godzivan/OpenPSX2AmigaPadAdapter/OpenPSX2AmigaPadAdapter.kicad_pcb

## KiCad design OpenPSX2AmigaPadAdapter.kicad_pcb (2020-04-24)

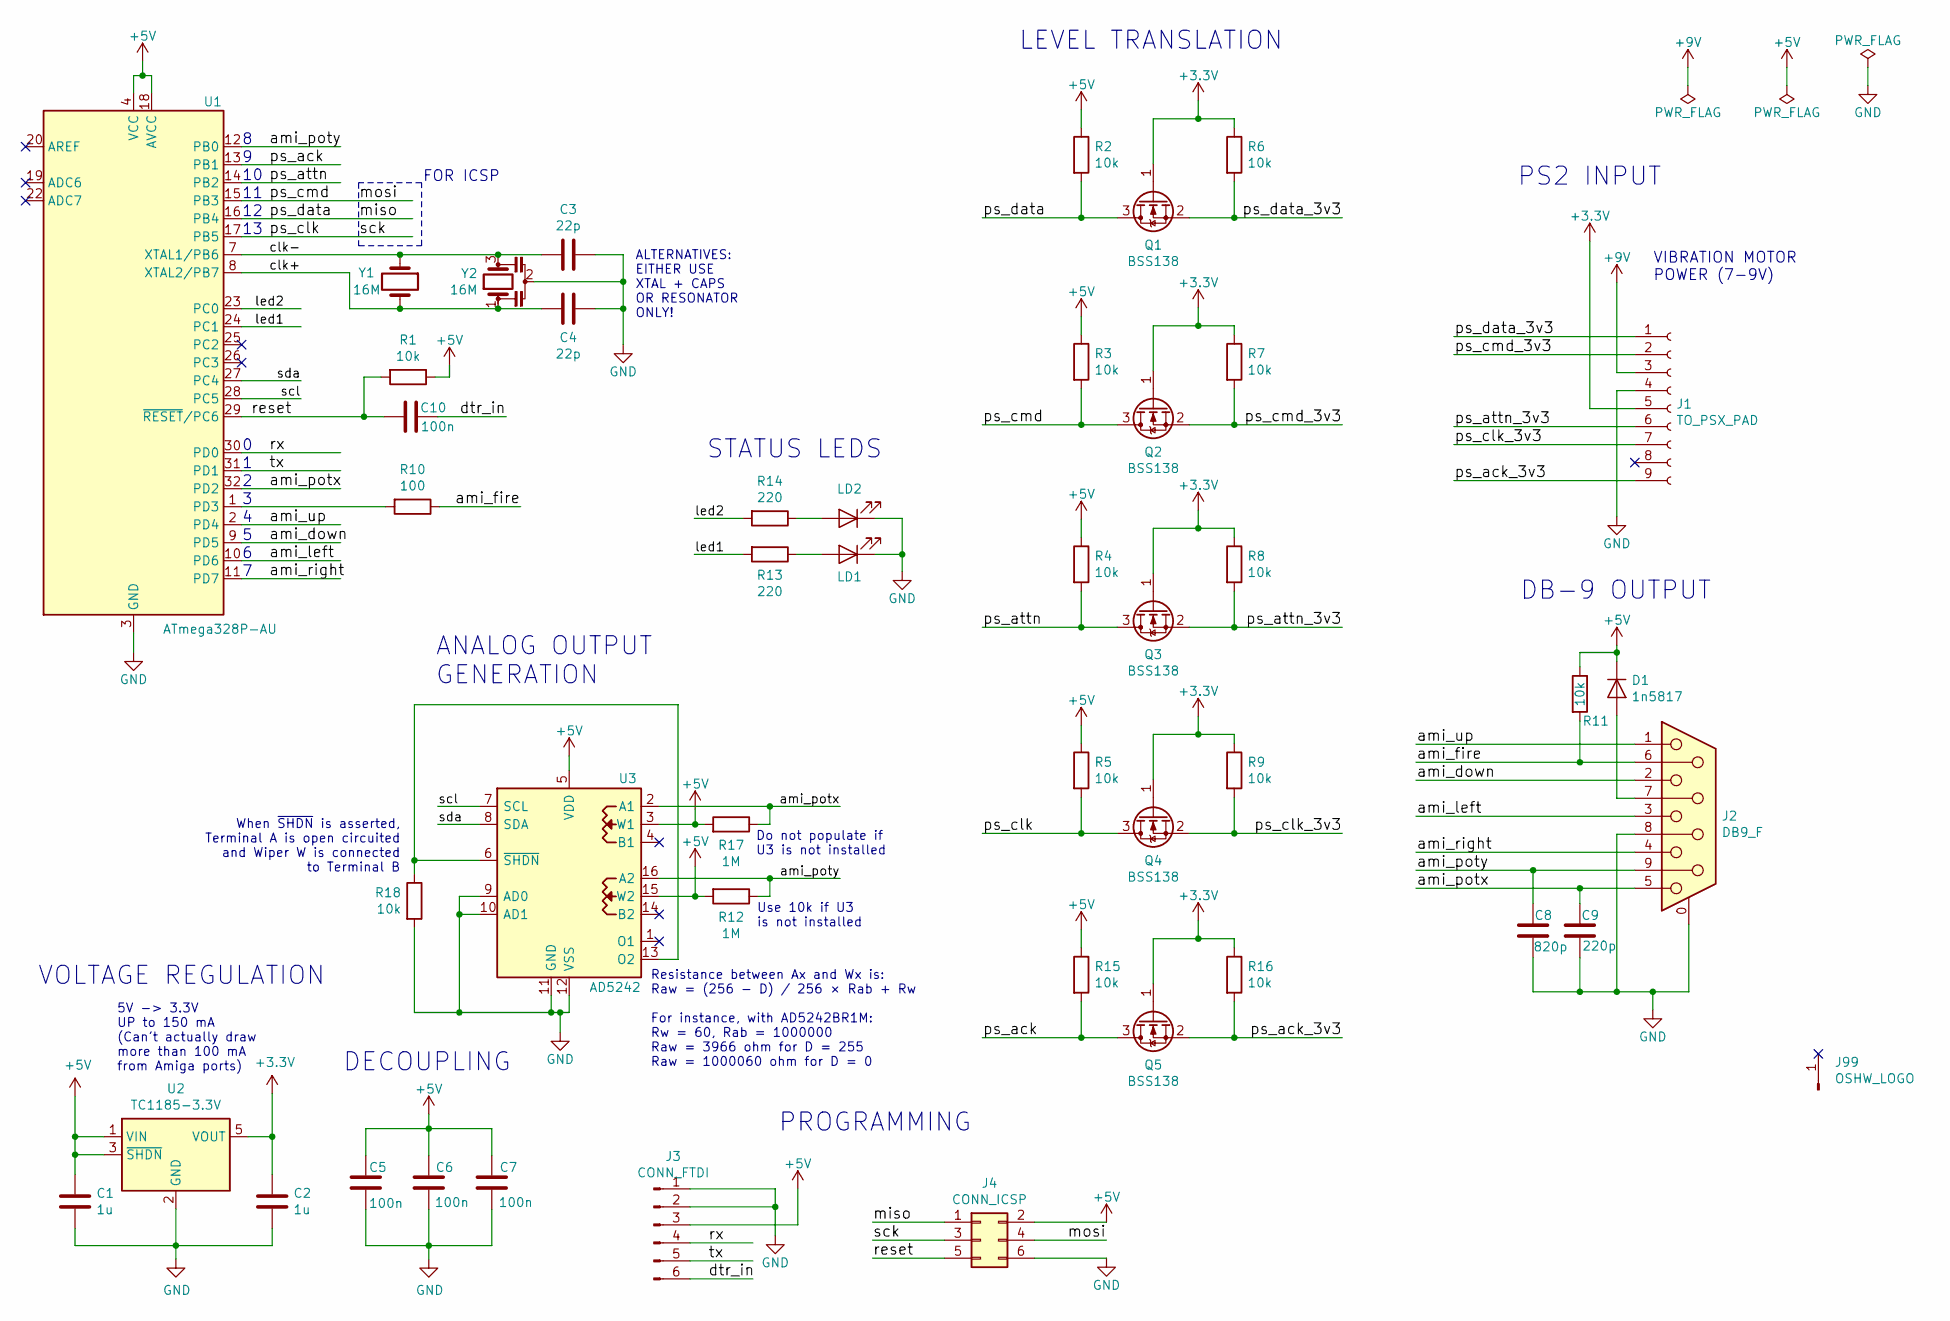
[picture p1: schematic OpenPSX2AmigaPadAdapter.sch]

Parts:
C1, C2: 1u; C_0805_2012Metric_Pad1.15x1.40mm_HandSolder
C3, C4: 22p; C_0805_2012Metric_Pad1.15x1.40mm_HandSolder
C5, C6, C7, C10: 100n; C_0805_2012Metric_Pad1.15x1.40mm_HandSolder
C8: 820p; C_0805_2012Metric_Pad1.15x1.40mm_HandSolder
C9: 220p; C_0805_2012Metric_Pad1.15x1.40mm_HandSolder
D1: 1n5817; D_SMA
J1: TO_PSX_PAD; PSX_Pad_Connector
J2: DB9_F; DB_9F
J3: CONN_FTDI; PinHeader_1x06_P2.54mm_Vertical
J4: CONN_ICSP; PinHeader_2x03_P2.54mm_Vertical
J99: OSHW_LOGO; OSHW-Logo_5.7x6mm_Copper
LD1, LD2: LED; LED_0805_2012Metric_Pad1.15x1.40mm_HandSolder
Q1, Q2, Q3, Q4, Q5: BSS138; SOT-23_Handsoldering
R1, R2, R3, R4, R5, R6, R7, R8, R9, R11, R15, R16, R18: 10k; R_0805_2012Metric_Pad1.15x1.40mm_HandSolder
R10: 100; R_0805_2012Metric_Pad1.15x1.40mm_HandSolder
R12, R17: 1M; R_0805_2012Metric_Pad1.15x1.40mm_HandSolder
R13, R14: 220; R_0805_2012Metric_Pad1.15x1.40mm_HandSolder
U1: ATmega328P-AU; TQFP-32_7x7mm_P0.8mm
U2: TC1185-3.3V; SOT-23-5_HandSoldering
U3: AD5242; SOIC-16_3.9x9.9mm_P1.27mm
Y1: 16M; Crystal_HC49-U_Vertical
Y2: 16M; Resonator_SMD_muRata_CSTxExxV

Connections:
+3V3: C2.1, J1.5, Q1.1 (G), Q2.1 (G), Q3.1 (G), Q4.1 (G), Q5.1 (G), R6.1, R7.1, R8.1, R9.1, R16.1, U2.5 (VOUT)
+5V: C1.1, C5.2, C6.2, C7.2, D1.1 (K), J3.3, J4.2, R1.1, R2.1, R3.1, R4.1, R5.1, R11.1, R12.2, R15.1, R17.2, U1.4 (VCC), U1.6 (VCC), U1.18 (AVCC), U2.1 (VIN), U2.3 (~SHDN), U3.3 (W1), U3.5 (VDD), U3.15 (W2)
/ami_down: J2.2, U1.9 (PD5)
/ami_fire: J2.6, R10.1, R11.2
/ami_left: J2.3, U1.10 (PD6)
/ami_potx: C9.1, J2.5, R17.1, U1.32 (PD2), U3.2 (A1)
/ami_poty: C8.1, J2.9, R12.1, U1.12 (PB0), U3.16 (A2)
/ami_right: J2.4, U1.11 (PD7)
/ami_up: J2.1, U1.2 (PD4)
/clk+: C4.2, U1.8 (XTAL2/PB7), Y1.2, Y2.1
/clk-: C3.2, U1.7 (XTAL1/PB6), Y1.1, Y2.3
/dtr_in: C10.1, J3.6
/led1: R13.2, U1.24 (PC1)
/led2: R14.2, U1.23 (PC0)
/miso: J4.1, Q1.3 (D), R2.2, U1.16 (PB4)
/mosi: J4.4, Q2.3 (D), R3.2, U1.15 (PB3)
/ps_ack: Q5.3 (D), R15.2, U1.13 (PB1)
/ps_ack_3v3: J1.9, Q5.2 (S), R16.2
/ps_attn: Q3.3 (D), R4.2, U1.14 (PB2)
/ps_attn_3v3: J1.6, Q3.2 (S), R8.2
/ps_clk: J4.3, Q4.3 (D), R5.2, U1.17 (PB5)
/ps_clk_3v3: J1.7, Q4.2 (S), R9.2
/ps_cmd_3v3: J1.2, Q2.2 (S), R7.2
/ps_data_3v3: J1.1, Q1.2 (S), R6.2
/reset: C10.2, J4.5, R1.2, U1.29 (~RESET~/PC6)
/rx: J3.4, U1.30 (PD0)
/scl: U1.28 (PC5), U3.7 (SCL)
/sda: U1.27 (PC4), U3.8 (SDA)
/tx: J3.5, U1.31 (PD1)
GND: C1.2, C2.2, C3.1, C4.1, C5.1, C6.1, C7.1, C8.2, C9.2, J1.4, J2.0 (PAD), J2.8, J3.1, J3.2, J4.6, LD1.1 (K), LD2.1 (K), R18.2, U1.3 (GND), U1.5 (GND), U1.21 (GND), U2.2 (GND), U3.9 (AD0), U3.10 (AD1), U3.11 (GND), U3.12 (VSS), Y2.2
unnamed: D1.2 (A), J2.7
unnamed: LD1.2 (A), R13.1
unnamed: LD2.2 (A), R14.1
unnamed: R10.2, U1.1 (PD3)
unnamed: R18.1, U3.6 (~SHDN~), U3.13 (O2)

Notes on the sheet:
VIBRATION MOTOR POWER (7-9V)
FOR ICSP
ALTERNATIVES: EITHER USE XTAL + CAPS OR RESONATOR ONLY!
When ~SHDN~ is asserted, Terminal A is open circuited and Wiper W is connected to Terminal B
5V -> 3.3V UP to 150 mA (Can't actually draw more than 100 mA from Amiga ports)
VOLTAGE REGULATION
DECOUPLING
ANALOG OUTPUT GENERATION
PROGRAMMING
STATUS LEDS
PS2 INPUT
DB-9 OUTPUT
LEVEL TRANSLATION
Resistance between Ax and Wx is: Raw = (256 − D) / 256 × Rab + Rw For instance, with AD5242BR1M: Rw = 60, Rab = 1000000 Raw = 3966 ohm for D = 255 Raw = 1000060 ohm for D = 0
Use 10k if U3 is not installed
Do not populate if U3 is not installed

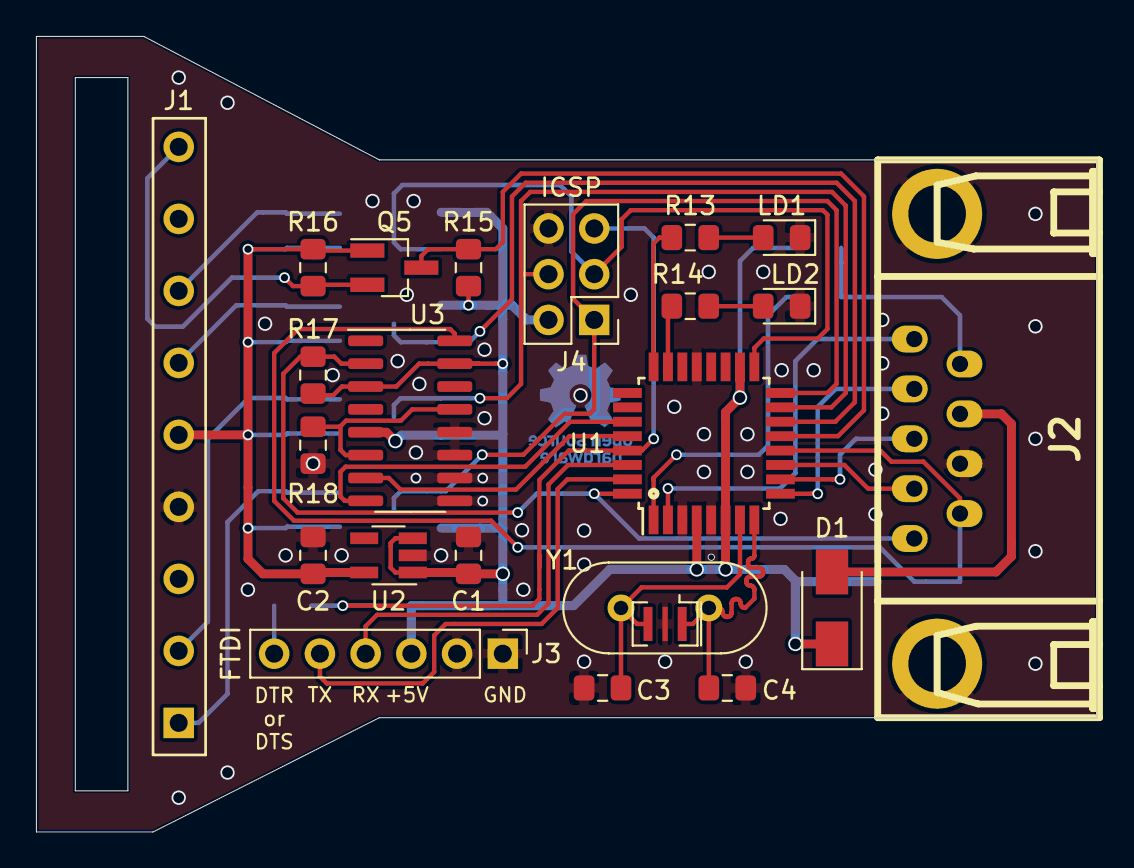
[picture p2: board OpenPSX2AmigaPadAdapter.kicad_pcb from above]

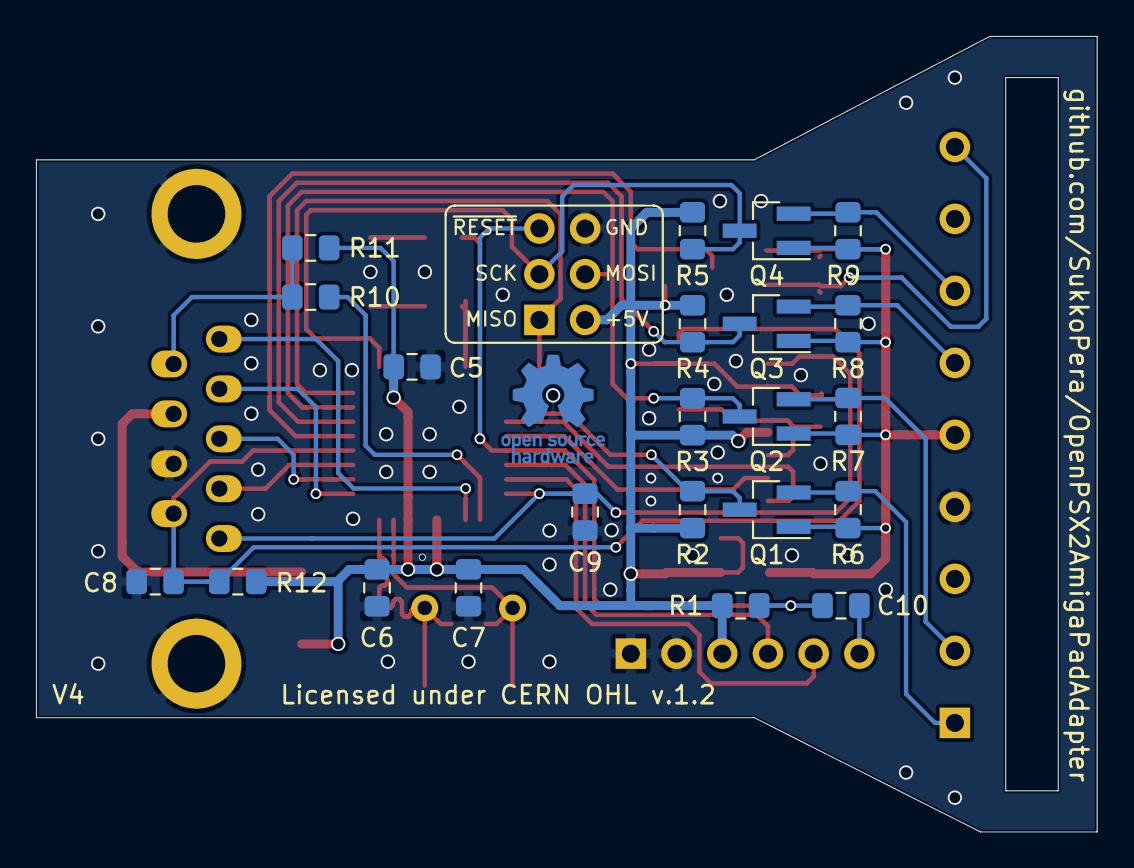
[picture p3: board OpenPSX2AmigaPadAdapter.kicad_pcb from below]

Board: 2 copper layers, 58.9 x 44.2 mm, 46 parts (23 on the bottom side), 35 nets.
