godzivan/OpenPSX2AmigaPadAdapter/firmware/OpenPSX2AmigaPadAdapter/OpenPSX2AmigaPadAdapter.ino

/*******************************************************************************
 * This file is part of OpenPSX2AmigaPadAdapter.                               *
 *                                                                             *
 * Copyright (C) 2019-2020 by SukkoPera <software@sukkology.net>               *
 *                                                                             *
 * OpenPSX2AmigaPadAdapter is free software: you can redistribute it and/or    *
 * modify it under the terms of the GNU General Public License as published by *
 * the Free Software Foundation, either version 3 of the License, or           *
 * (at your option) any later version.                                         *
 *                                                                             *
 * OpenPSX2AmigaPadAdapter is distributed in the hope that it will be useful,  *
 * but WITHOUT ANY WARRANTY; without even the implied warranty of              *
 * MERCHANTABILITY or FITNESS FOR A PARTICULAR PURPOSE.  See the               *
 * GNU General Public License for more details.                                *
 *                                                                             *
 * You should have received a copy of the GNU General Public License           *
 * along with OpenPSX2AmigaPadAdapter. If not, see http://www.gnu.org/licenses.*
 ******************************************************************************/
/**
 * \file OpenPSX2AmigaPadAdapter.ino
 * \author SukkoPera <software@sukkology.net>
 * \date 26 Mar 2020
 * \brief Playstation to Commodore Amiga/CD32 controller adapter
 *
 * Please refer to the GitHub page and wiki for any information:
 * https://github.com/SukkoPera/OpenPSX2AmigaPadAdapter
 */

#include <PsxNewLib.h>
#include <PsxControllerHwSpi.h>

/** \brief Enable heavy optimization
 * 
 * This enables some inline assembly code, GCC-style ISRs, etc.
 * 
 * Code has only been tested with this being enabled, so you'd better not touch
 * it.
 */
#define SUPER_OPTIMIZE

/** \brief Enable fast control of I/O pins
 *
 * This enables very fast (2 clock cycles) control of I/O pins. The DigitalIO
 * library by greiman is needed for this: https://github.com/greiman/DigitalIO.
 * 
 * This is basically mandatory for all targets currently supported, where the
 * Arduino digitalRead()/digitalWrite() functions are too slow. This define is
 * provided to make it easy to transition to faster platforms one day, should we
 * ever want to.
 */
#define ENABLE_FAST_IO

/** \def ENABLE_INSTRUMENTATION
 * 
 * \brief Enable code instrumentation
 *
 * This makes a couple of I/O pins toggle whenever ISRs are entered and is a
 * means to measure how long they take to execute fully, by using a logic
 * analyzer or oscilloscope.
 * 
 * Disabled by default.
 */
//~ #define ENABLE_INSTRUMENTATION

/** \def DISABLE_FACTORY_RESET
 *
 * \brief Disable factory reset
 * 
 * This disables the factory reset for joystick configurations. The only point
 * here is to save some flash, for ATmega88 targets. EEPROM can be cleared with
 * the \a eeprom_clear Arduino example.
 * 
 * At the moment we fit on all supported targets with this enabled, so just
 * ignore it.
 */
//~ #define DISABLE_FACTORY_RESET

/** \def #ifndef DISABLE_TEST_MODE
 *
 * \brief Disable controller test mode
 * 
 * This disables the controller test mode that is entered by holding \a START
 * at power-up. The only point again is to save some flash, for ATmega88
 * targets.
 */
//~ #define DISABLE_TEST_MODE

/** \def DISABLE_EEPROM
 *
 * \brief Disable EEPROM support
 * 
 * This disables loading and storing controller configurations from/to the
 * internal EEPROM. Only useful for development.
 */
//~ #define DISABLE_EEPROM

/** \def ENABLE_ANALOG_SUPPORT
 *
 * \brief Enable support for analog joystick output
 *
 * This enables capability for the adapter to appear as an analog joystick. The
 * horizontal and vertical movement of the controller will be somehow reflected
 * on the PotX and PotY pins. Of course this will only work if an analog-capable
 * controller is connected.
 *
 * A V4 PCB with an AD5242 chip is needed for this functionality.
 */
#define ENABLE_ANALOG_SUPPORT

//~ #define DISABLE_ANALOG_OUTPUT_COMPENSATION

//! \name OUTPUT pins, connected to Amiga port
//! @{
const byte PIN_UP = 4;    //!< Amiga Pin 1
const byte PIN_DOWN = 5;  //!< Amiga Pin 2
const byte PIN_LEFT = 6;  //!< Amiga Pin 3
const byte PIN_RIGHT = 7; //!< Amiga Pin 4
const byte PIN_BTN1 = 3;  //!< Amiga Pin 6
const byte PIN_BTN2 = 8;  //!< Amiga Pin 9
//! @}

/** \brief Controller mode input pin
 *  
 * This pin switches between Amiga (HIGH) and CD32 (LOW) mode.
 * 
 * It also triggers the loading of the button status shift register.
 */
const byte PIN_PADMODE = 2; // Amiga Pin 5

/** \brief Shift register output pin for CD32 mode
 * 
 * When in CD32 mode, button status is saved to an 8-bit register that gets
 * shifted out one bit at a time through this pin.
 */
const byte PIN_BTNREGOUT = PIN_BTN2;

/** \brief Shift register clock input pin for CD32 mode
 * 
 * The shifting is clocked by rising edges on this pin.
 */
const byte PIN_BTNREGCLK = PIN_BTN1;

#ifdef ENABLE_ANALOG_SUPPORT
/** \brief PotX Analog input pin
 * 
 * Only used in analog mode. Note that most games actually use this for the Y
 * axis.
 *
 * \sa PIN_POTY
 */
const byte PIN_POTX = PIN_PADMODE;		// Pin 5

/** \brief PotY Analog input pin
 * 
 * Only used in analog mode.
 *
 * \sa PIN_POTX
 */
const byte PIN_POTY = PIN_BTN2;			// Pin 5

const byte RDAC_PULLUP_VALUE = 253;		// 11642 ohm
#endif

/** \brief Dead zone for analog sticks
 *  
 * If the analog stick moves less than this value from the center position, it
 * is considered still.
 * 
 * \sa ANALOG_IDLE_VALUE
 */
const byte ANALOG_DEAD_ZONE = 50U;

/** \brief Controller polling frequency
 *
 * Polling the PS2 controller takes a considerable amount of time, so we cannot
 * do that all the time. Considering that an Amiga game cannot read inputs more
 * than once every frame, 60 seems a reasonable value here, taking care of both
 * PAL and NTSC machines.
 */
const byte PAD_POLLING_FREQ = 60U;

/** \brief Delay of the quadrature square waves when mouse is moving at the
 * \a slowest speed
 */
const byte MOUSE_SLOW_DELTA	= 250U;

/** \brief Delay of the quadrature square waves when mouse is moving at the
 * \a fastest speed.
 */
const byte MOUSE_FAST_DELTA = 10U;

/** \brief LED2 pin
 * 
 * Pin for led that lights up whenever the proper controller is detected.
 */
const byte PIN_LED_PAD_OK = A1;

/** \brief LED1 pin
 * 
 * Pin for led that lights up whenever the adapter is in CD32 mode.
 */
const byte PIN_LED_MODE = A0;

/** \brief Pin used for Controller Attention (ATTN)
 *
 * Pin that makes the controller pay attention to what we're saying.
 */
const byte PIN_CONTROLLER_ATTN = 10;

/** \brief CD32 mode timeout
 * 
 * Normal joystick mode will be entered if PIN_PADMODE is not toggled for this
 * amount of milliseconds.
 * 
 * Keep in mind that in normal conditions it is toggled once per frame (i.e.
 * every ~20 ms).
 */
const byte TIMEOUT_CD32_MODE = 100U;

/** \brief Programming mode timeout
 * 
 * Programming mode will be entered if SELECT + a button are held for this
 * amount of milliseconds.
 */
const unsigned long TIMEOUT_PROGRAMMING_MODE = 1000U;

/** \brief Single-button debounce time
 * 
 * A combo will be considered valid only after it has been stable for this
 * amount of milliseconds.
 * 
 * \sa debounceButtons()
 */
const unsigned long DEBOUNCE_TIME_BUTTON = 30U;

/** \brief Combo debounce time
 * 
 * A combo will be considered valid only after it has been stable for this
 * amount of milliseconds. This needs to be greater than #DEBOUNCE_TIME_BUTTON
 * to allow combos to be entered correctly, as it's hard to press several
 * buttons at exactly the same moment.
 * 
 * \sa debounceButtons()
 */
const unsigned long DEBOUNCE_TIME_COMBO = 150U;


/*******************************************************************************
 * DEBUGGING SUPPORT
 ******************************************************************************/

// Send debug messages to serial port
//~ #define ENABLE_SERIAL_DEBUG

// Print the controller status on serial. Useful for debugging.
//~ #define DEBUG_PAD

// Print the duration of every loop() iteration
//~ #define ENABLE_DEBUG_LOOP_DURATION


/*******************************************************************************
 * END OF SETTINGS
 ******************************************************************************/

#ifndef DISABLE_EEPROM
#include <EEPROM.h>
#include <util/crc16.h>
#endif

#ifdef ENABLE_FAST_IO
#include <DigitalIO.h>		// https://github.com/greiman/DigitalIO
#else
#define fastDigitalRead(x) digitalRead(x)
#define fastDigitalWrite(x, y) digitalWrite(x, y)
#define fastPinMode(x, y) pinMode(x, y)
#endif

#ifdef ENABLE_INSTRUMENTATION
#define PIN_INTERRUPT_TIMING A2
#define PIN_CD32MODE A4
#endif

#ifdef ENABLE_ANALOG_SUPPORT
#include "VariableResistor.h"
VariableResistor variableResistor;
boolean haveAnalogCapability = false;
#endif

//! \name Button bits for CD32 mode
//! @{
const byte BTN_BLUE =		1U << 0U;	//!< \a Blue Button
const byte BTN_RED =		1U << 1U;	//!< \a Red Button
const byte BTN_YELLOW =		1U << 2U;	//!< \a Yellow Button
const byte BTN_GREEN =		1U << 3U;	//!< \a Green Button
const byte BTN_FRONT_R =	1U << 4U;	//!< \a Front \a Right Button
const byte BTN_FRONT_L =	1U << 5U;	//!< \a Front \a Left Button
const byte BTN_START =		1U << 6U;	//!< \a Start/Pause Button
//! @}

#define ATTR_PACKED __attribute__((packed))

/** \brief State machine states
 * 
 * Possible states for the internal state machine that drives the whole thing.
 * 
 * Note that we make this \a packed so that it fits in a single byte.
 */
enum ATTR_PACKED State {
	ST_NO_CONTROLLER,			//!< No controller connected
	ST_FIRST_READ,				//!< First time the controller is read

#ifndef DISABLE_TEST_MODE
	ST_TEST_MODE,				//!< Controller test mode
#endif
	
	// Main functioning modes
	ST_JOYSTICK,				//!< Two-button joystick mode
	ST_MOUSE,					//!< Mouse mode
	ST_CD32,					//!< CD32-controller mode
	ST_JOYSTICK_TEMP,			//!< Just come out of CD32 mode, will it last?
	
	// States to select mapping or go into programming mode
	ST_SELECT_HELD,				//!< Select being held
	ST_SELECT_AND_BTN_HELD,		//!< Select + mapping button being held
	ST_ENABLE_MAPPING,			//!< Select + mapping button released, enable mapping
	
	// States for programming mode
	ST_WAIT_SELECT_RELEASE,		//!< Select released, entering programming mode
	ST_WAIT_BUTTON_PRESS,		//!< Programmable button pressed
	ST_WAIT_BUTTON_RELEASE,		//!< Programmable button released
	ST_WAIT_COMBO_PRESS,		//!< Combo pressed
	ST_WAIT_COMBO_RELEASE,		//!< Combo released
	ST_WAIT_SELECT_RELEASE_FOR_EXIT,	//!< Wait for select to be released to go back to joystick mode
	
	// States for factory reset
#ifndef DISABLE_FACTORY_RESET
	ST_FACTORY_RESET_WAIT_1,
	ST_FACTORY_RESET_WAIT_2,
	ST_FACTORY_RESET_PERFORM,
#endif

	// States for analog output support
#ifdef ENABLE_ANALOG_SUPPORT
	ST_ANALOG,					//!< Analog joystick mode
	ST_ANALOG_SELECT_HELD,
	ST_ANALOG_SELECT_AND_BTN_HELD,
	ST_ANALOG_ENABLE_MAPPING,
#endif
};

/** \brief All possible button mappings
 * 
 * This is only used for blinking the led when mapping is changed
 */
enum ATTR_PACKED JoyButtonMapping {
	JMAP_NORMAL = 1,
	JMAP_RACING1,
	JMAP_RACING2,
	JMAP_PLATFORM,
	JMAP_CUSTOM
};

/** \brief Structure representing a standard 2-button Atari-style joystick
 * 
 * This is used for gathering button presses according to different button
 * mappings.
 * 
 * True means pressed.
 * 
 * We use bitfields so that it all fits in a single byte.
 */
struct TwoButtonJoystick {
	boolean up: 1;			//!< Up/Forward direction
	boolean down: 1;		//!< Down/Backwards direction
	boolean left: 1;		//!< Left direction
	boolean right: 1;		//!< Right direction
	boolean b1: 1;			//!< Button 1
	boolean b2: 1;			//!< Button 2
};

#ifdef ENABLE_ANALOG_SUPPORT
/** \brief Structure representing an Analog Joystick for the Amiga
 * 
 * This is used for gathering axis movement and button presses.
 * 
 * For the buttons, \a True means pressed. Note that most (if not all) games
 * support up to 2 buttons, but the \a AnaCal calibration program supports 4, so
 * why not?
 */
struct AnalogJoystick {
	byte analogX;			//!< Horizontal axis
	byte analogY;			//!< Vertical axis
	boolean b1: 1;			//!< Button 1
	boolean b2: 1;			//!< Button 2
	boolean b3: 1;			//!< Button 3
	boolean b4: 1;			//!< Button 4
};
#endif

/** \brief Map a PSX button to a two-button-joystick combo
 * 
 * There's an entry for every button, even those that cannot be mapped, for
 * future extension.
 *
 * Use #psxButtonToIndex() to convert a button to the index to use in the array.
 * 
 * \sa isButtonMappable()
 */
struct ControllerConfiguration {
	/** Two-button joystick combo to send out when the corresponding button is
	 * pressed
	 */
	TwoButtonJoystick buttonMappings[PSX_BUTTONS_NO];
};

//! \name Global variables
//! @{

//! PS2 Controller Class
PsxControllerHwSpi<PIN_CONTROLLER_ATTN> psx;

/** \brief Current state of the internal state machine
 * 
 * We start out as a simple joystick.
 * 
 * We keep this in \a GPIOR2 for faster access and slimmer code.
 * 
 * \hideinitializer
 */
volatile State *state = reinterpret_cast<volatile State *> (&GPIOR2);

/** \brief All possible controller configurations
 * 
 * Since these are activated with SELECT + a button, ideally there can be as
 * many different ones as other buttons we have (i.e.: PSX_BUTTONS_NO). In
 * practice, we will start handling only a handful.
 */
ControllerConfiguration controllerConfigs[PSX_BUTTONS_NO];

//! \brief Custom controller configuration currently selected
ControllerConfiguration *currentCustomConfig = NULL;

/** \brief Button register for CD32 mode being updated
 * 
 * This shall be updated as often as possible, and is what gets sampled when we
 * get a falling edge on #PIN_PADMODE.
 * 
 * 0 means pressed, MSB must be 1 for the ID sequence.
 * 
 * We keep this in \a GPIOR0 for faster ISR code. Note that GPIOR0 is one of the
 * lowest 64 registers on ATmega88/168/328's, thus it can be used with
 * SBI/CBI/SBIC/SBIS. I don't know if GCC takes advantage of this, but we do in
 * the \a asm_isr branch.
 * 
 * \hideinitializer
 */
volatile byte *buttonsLive = &GPIOR0;

/** \brief Button register for CD32 mode currently being shifted out
 * 
 * This is where #buttonsLive gets copied when it is sampled.
 * 
 * 0 means pressed, etc.
 * 
 * We keep this in \a GPIOR1 for faster ISR code.
 * 
 * \hideinitializer
 */
volatile byte *isrButtons = &GPIOR1;

/** \brief Joystick mapping function
 * 
 * This represents a function that should inspect the buttons currently being
 * pressed on the PSX controller and somehow map them to a #TwoButtonJoystick to
 * be sent to the DB-9 port.
 */
typedef void (*JoyMappingFunc) (TwoButtonJoystick& j);

// Default button mapping function prototype for initialization of the following
void mapJoystickNormal (TwoButtonJoystick& j);

//! \brief Joystick mapping function currently in effect (Digital Mode)
JoyMappingFunc joyMappingFunc = mapJoystickNormal;

#ifdef ENABLE_ANALOG_SUPPORT
/** \brief Analog Joystick mapping function
 * 
 * This represents a function that should inspect the buttons currently being
 * pressed on the PSX controller and somehow map them to a #AnalogJoystick to be
 * sent to the DB-9 port.
 */
typedef void (*AnalogJoyMappingFunc) (AnalogJoystick& j);

void mapJoystickAnalogLeft (AnalogJoystick& j);

//! \brief Joystick mapping function currently in effect (Analog Mode)
AnalogJoyMappingFunc analogJoyMappingFunc = mapJoystickAnalogLeft;

/** \brief Swap X/Y axes
 * 
 * There is no real standard for analog joysticks on the Amiga, so different
 * games map the X/Y axes differently. Let's cope with that!
 */
boolean swapAnalogAxes = false;

#ifndef DISABLE_ANALOG_OUTPUT_COMPENSATION

const byte rcompensated[256] = {
	255,  255,  255,  255,  254,  254,  253,  253,  
	252,  252,  251,  251,  250,  250,  249,  249,  
	248,  248,  247,  247,  246,  246,  245,  245,  
	244,  244,  243,  243,  242,  242,  241,  241,  
	240,  240,  239,  238,  238,  237,  237,  236,  
	236,  235,  235,  234,  234,  233,  232,  232,  
	231,  231,  230,  230,  229,  228,  228,  227,  
	227,  226,  226,  225,  224,  224,  223,  223,  
	222,  221,  221,  220,  219,  219,  218,  218,  
	217,  216,  216,  215,  215,  214,  213,  213,  
	212,  211,  211,  210,  209,  209,  208,  207,  
	207,  206,  205,  205,  204,  203,  203,  202,  
	201,  201,  200,  199,  198,  198,  197,  196,  
	196,  195,  194,  193,  193,  192,  191,  190,  
	190,  189,  188,  187,  187,  186,  185,  184,  
	184,  183,  182,  181,  181,  180,  179,  178,  
	177,  177,  176,  175,  174,  173,  172,  172,  
	171,  170,  169,  168,  167,  167,  166,  165,  
	164,  163,  162,  161,  161,  160,  159,  158,  
	157,  156,  155,  154,  153,  152,  151,  150,  
	150,  149,  148,  147,  146,  145,  144,  143,  
	142,  141,  140,  139,  138,  137,  136,  135,  
	134,  133,  132,  131,  130,  129,  128,  126,  
	125,  124,  123,  122,  121,  120,  119,  118,  
	117,  116,  114,  113,  112,  111,  110,  109,  
	107,  106,  105,  104,  103,  102,  100,  99,  
	98,  97,  95,  94,  93,  92,  90,  89,  
	88,  86,  85,  84,  83,  81,  80,  79,  
	77,  76,  74,  73,  72,  70,  69,  67,  
	66,  65,  63,  62,  60,  59,  57,  56,  
	54,  53,  51,  50,  48,  47,  45,  44,  
	42,  40,  39,  37,  36,  34,  32,  31,  
};

#endif

#endif

/** \brief Commodore 64 mode
 *
 * Button 2 on the C64 is usually expected to behave differently from the other
 * buttons, so that it is HIGH when pressed and LOW when released.
 *
 * If this flag is true, we'll do exactly that.
 */
boolean c64Mode = false;

/** \brief Use alternative CD32 mapping
 * 
 * To me the Red button maps naturally to Square, Blue to Cross and so on. Some
 * people feel this way buttons are "rotated" with regard to the original CD32
 * controller, hence let's give them the possibility to "counter-rotate" the
 * mapping so that Cross is Red, Circle is Blue and so on.
 */
boolean useAlternativeCd32Mapping = false;

/** \brief Inhibit CD32 mode
 * 
 * This inhibits the CD32 mode. Useful in those cases where pin 5 is not kept
 * high.
 *
 * This is enabled by holding \a Cross at power-up.
 */
boolean inhibitCd32Mode = false;

//! @}		// End of global variables

#ifdef ENABLE_SERIAL_DEBUG
	#include <avr/pgmspace.h>
	typedef const __FlashStringHelper * FlashStr;
	typedef const byte* PGM_BYTES_P;
	#define PSTR_TO_F(s) reinterpret_cast<const __FlashStringHelper *> (s)

	#define dstart(spd) Serial.begin (spd)
	#define debug(...) Serial.print (__VA_ARGS__)
	#define debugln(...) Serial.println (__VA_ARGS__)
#else
	#define dstart(...)
	#define debug(...)
	#define debugln(...)
#endif

/** \brief Initialize the Playstation controller
 * 
 * Note that this function takes a considerable amount of time.
 * 
 * \return True if a supported controller was found, false otherwise.
 */
boolean initPad () {
	boolean ret = false;

	// clock, command, attention, data, Pressures?, Rumble?
	if (psx.begin ()) {
		// Controller seems ready
		if (!psx.enterConfigMode ()) {
			/* We'll take this as good anyway, maybe it's an early controller
			 * that does not support any configuration, like the Namco Arcade
			 * Stick
			 */
			debugln (F("Cannot enter config mode"));
			ret = true;
		} else {
			switch (psx.getControllerType ()) {
			case PSCTRL_UNKNOWN:
				/* The Dual Shock controller gets recognized as this sometimes, or
				 * anyway, whatever controller it is, it might work
				 */
				debugln (F("Unknown Controller type found, using anyway"));
				ret = true;
				break;
			case PSCTRL_DUALSHOCK:
				debugln (F("DualShock Controller found"));
				ret = true;
				break;
			case PSCTRL_GUITHERO:
				/* We used to refuse this, as it does not look suitable, but then we
				 * found out that the Analog Controller (SCPH-1200) gets detected as
				 * this... :/
				 */
				debugln (F("Analog/GuitarHero Controller found"));
				ret = true;
				break;
			case PSCTRL_DSWIRELESS:
				debugln (F("Wireless Sony DualShock Controller found"));
				ret = true;
				break;
			}

			// Try to enable analog sticks
			if (!psx.enableAnalogSticks ()) {
				debugln (F("Cannot enable analog sticks"));
			}
							
			if (!psx.exitConfigMode ()) {
				debugln (F("Cannot exit config mode"));
			}
		}
	} else {
		debugln (F("No controller found"));
	}

	return ret;
}


/** \name Button name strings
 * 
 * These are only used for debugging and will not show up in the executable if
 * it is not enabled
 */
//! @{
const char buttonSelectName[] PROGMEM = "Select";
const char buttonL3Name[] PROGMEM = "L3";
const char buttonR3Name[] PROGMEM = "R3";
const char buttonStartName[] PROGMEM = "Start";
const char buttonUpName[] PROGMEM = "Up";
const char buttonRightName[] PROGMEM = "Right";
const char buttonDownName[] PROGMEM = "Down";
const char buttonLeftName[] PROGMEM = "Left";
const char buttonL2Name[] PROGMEM = "L2";
const char buttonR2Name[] PROGMEM = "R2";
const char buttonL1Name[] PROGMEM = "L1";
const char buttonR1Name[] PROGMEM = "R1";
const char buttonTriangleName[] PROGMEM = "Triangle";
const char buttonCircleName[] PROGMEM = "Circle";
const char buttonCrossName[] PROGMEM = "Cross";
const char buttonSquareName[] PROGMEM = "Square";

const char* const psxButtonNames[PSX_BUTTONS_NO] PROGMEM = {
	buttonSelectName,
	buttonL3Name,
	buttonR3Name,
	buttonStartName,
	buttonUpName,
	buttonRightName,
	buttonDownName,
	buttonLeftName,
	buttonL2Name,
	buttonR2Name,
	buttonL1Name,
	buttonR1Name,
	buttonTriangleName,
	buttonCircleName,
	buttonCrossName,
	buttonSquareName
};
//! @}

/** \brief Convert a button on the PSX controller to a small integer
 * 
 * Output will always be in the range [0, PSX_BUTTONS_NO - 1] and is not
 * guaranteed to be valid, so it should be checked to be < PSX_BUTTONS_NO before
 * use.
 * 
 * \param[in] psxButtons Button to be converted
 * \return A small integer corresponding to the "first" button pressed
 */
byte psxButtonToIndex (PsxButtons psxButtons) {
	byte i;

	for (i = 0; i < PSX_BUTTONS_NO; ++i) {
		if (psxButtons & 0x01) {
			break;
		}

		psxButtons >>= 1U;
	}

	return i;
}

#ifdef ENABLE_SERIAL_DEBUG
/** \brief Return the name of a PSX button
 * 
 * \param[in] psxButtons Button to be converted
 * \return A string (in flash) containing the name of the "first" buton pressed
 */
FlashStr getButtonName (const PsxButtons psxButton) {
	FlashStr ret = F("");
	
	byte b = psxButtonToIndex (psxButton);
	if (b < PSX_BUTTONS_NO) {
		PGM_BYTES_P bName = reinterpret_cast<PGM_BYTES_P> (pgm_read_ptr (&(psxButtonNames[b])));
		ret = PSTR_TO_F (bName);
	}

	return ret;
}
#endif

/** \brief Print the names of all PSX buttons being pressed
 * 
 * \param[in] psxButtons Buttons to be printed
 */
void dumpButtons (const PsxButtons psxButtons) {
#ifdef DEBUG_PAD
	static PsxButtons lastB = 0;

	if (psxButtons != lastB) {
		lastB = psxButtons;			// Save it before we alter it
		
		debug (F("Pressed: "));

		for (byte i = 0; i < PSX_BUTTONS_NO; ++i) {
			byte b = psxButtonToIndex (psxButtons);
			if (b < PSX_BUTTONS_NO) {
				PGM_BYTES_P bName = reinterpret_cast<PGM_BYTES_P> (pgm_read_ptr (&(psxButtonNames[b])));
				debug (PSTR_TO_F (bName));
			}

			psxButtons &= ~(1 << b);

			if (psxButtons != 0) {
				debug (F(", "));
			}
		}

		debugln ();
	}
#else
	(void) psxButtons;
#endif
}

/** \brief Disable the ISR servicing rising clock edges
 * 
 * This shall be called when CD32 mode is exited.
 */
inline void suspendClockInterrupt () {
	EIMSK &= ~(1 << INT1);
}

/** \brief Enable the ISR servicing rising clock edges
 * 
 * This shall be called when CD32 mode is entered.
 */
inline void restoreClockInterrupt () {
	EIFR |= (1 << INTF1);		// Clear any pending interrupts
	EIMSK |= (1 << INT1);
}

/** \brief ISR servicing edges on #PIN_PADMODE
 *
 * Called on PIN_PADMODE changing, this function shall set things up for CD32
 * mode, sample buttons and shift out the first bit on FALLING edges, and
 * restore Atari-style signals on RISING edges.
 */
#ifndef SUPER_OPTIMIZE
void onPadModeChange () {
#else
ISR (INT0_vect) {
#endif
#ifdef ENABLE_INSTRUMENTATION
	fastDigitalToggle (PIN_INTERRUPT_TIMING);
#endif

	// Enable INT1, i.e. interrupt on clock edges
	restoreClockInterrupt ();

	if (fastDigitalRead (PIN_PADMODE) == LOW) {
		// Switch to CD32 mode
		debugln (F("Joystick -> CD32"));
		
		// Output status of first button as soon as possible
		if (!(*buttonsLive & 0x01)) {
			fastDigitalWrite (PIN_BTNREGOUT, LOW);
		} else {
			fastDigitalWrite (PIN_BTNREGOUT, HIGH);
		}
		fastPinMode (PIN_BTNREGOUT, OUTPUT);	/* Switch pin to output *after*
												 * toggling it to avoid a
												 * spurious 0V state when
												 * going from input to high
												 * output (keep in mind pull-up
												 * is external).
												 */

		/* Disable output on clock pin. No need to rush here, as we have a
		 * protecting resistor, but anyway when the CD32 drives it high, it's
		 * doing that through a pull-up, it's not driving the line directly.
		 */
		fastPinMode (PIN_BTNREGCLK, INPUT);
				
		/* Sample input values, they will be shifted out on subsequent clock
		 * inputs.
		 * 
		 * At this point MSB must be 1 for ID sequence. Then it will be zeroed
		 * by the shift. This will report non-existing buttons 8 as released and
		 * 9 as pressed as required by the ID sequence.
		 */
#ifndef SUPER_OPTIMIZE
		*isrButtons = *buttonsLive >> 1U;
#else
		asm volatile (
			"lsr %0\n\t"
			: "=r" (*isrButtons)
			: "r" (*buttonsLive)
		);
#endif

		//~ TIMSK0 &= ~(1 << TOIE0);

		// Set state to ST_CD32
		*state = ST_CD32;

#ifdef ENABLE_INSTRUMENTATION
		fastDigitalToggle (PIN_CD32MODE);
#endif
	} else {
		// Switch back to joystick mode
		debugln (F("CD32 -> Joystick"));

		/* Set pin directions and set levels according to buttons, as waiting
		 * for the main loop to do it takes too much time (= a few ms), for some
		 * reason
		 */
		/* PIN_BTN1 (aka PIN_BTNREGCLK) was an INPUT and it must either remain
		 * an input or become a low output, so this should be enough
		 */
		if (!(*buttonsLive & BTN_RED)) {
			buttonPress (PIN_BTN1);
		} else {
			buttonRelease (PIN_BTN1);
		}
		
		/* PIN_BTN2 (aka PIN_BTNREGOUT) was an output, either high or low, which
		 * means it might turn into a pulled-up input
		 */
		if (!(*buttonsLive & BTN_BLUE)) {
			// To LOW OUTPUT
			buttonPress (PIN_BTN2);
		} else {
			// To INPUT
			buttonRelease (PIN_BTN2);
		}
		fastDigitalWrite (PIN_BTN2, LOW);	/* Disable pull-up, don't do it before
											 * to avoid a spurious 0V state when
											 * going from output high to input
											 */
		
		// Disable INT1
		suspendClockInterrupt ();

		//~ TIMSK0 |= 1 << TOIE0;
		
		// Set state to ST_JOYSTICK_TEMP
		*state = ST_JOYSTICK_TEMP;
		
#ifdef ENABLE_INSTRUMENTATION
		fastDigitalToggle (PIN_CD32MODE);
#endif
	}

#ifdef ENABLE_INSTRUMENTATION
	fastDigitalToggle (PIN_INTERRUPT_TIMING);
#endif
}

/** \brief ISR servicing rising edges on #PIN_BTNREGCLK
 * 
 * Called on clock pin rising, this function shall shift out next bit.
 */
#ifndef SUPER_OPTIMIZE
void onClockEdge () {
#else
ISR (INT1_vect) {
#endif
#ifdef ENABLE_INSTRUMENTATION
	fastDigitalToggle (PIN_INTERRUPT_TIMING);
#endif

	if (!(*isrButtons & 0x01)) {
		fastDigitalWrite (PIN_BTNREGOUT, LOW);
	} else {
		fastDigitalWrite (PIN_BTNREGOUT, HIGH);
	}

#ifndef SUPER_OPTIMIZE
	*isrButtons >>= 1U;	/* Again, non-existing button 10 will be reported as
						 * pressed for the ID sequence
						 */
#else
	asm volatile (
		"lsr %0\n\t"
	   : "=r" (*isrButtons)
	   : "0" (*isrButtons)
	);
#endif

#ifdef ENABLE_INSTRUMENTATION
	fastDigitalToggle (PIN_INTERRUPT_TIMING);
#endif
}

/** \brief Enable CD32 controller support
 * 
 * CD32 mode is entered automatically whenever a HIGH level is detected on
 * #PIN_PADMODE, after this function has been called.
 */
inline void enableCD32Trigger () {
	if (!inhibitCd32Mode) {
		noInterrupts ();
		
		/* Clear any pending interrupts, see
		 * https://github.com/arduino/ArduinoCore-avr/issues/244
		 */
		EIFR |= (1 << INTF0);

#ifndef SUPER_OPTIMIZE
		// Enable interrupt 0 (i.e.: on pin 2)...
		attachInterrupt (digitalPinToInterrupt (PIN_PADMODE), onPadModeChange, CHANGE);

		// ... and interrupt 1 (pin 3)
		attachInterrupt (digitalPinToInterrupt (PIN_BTNREGCLK), onClockEdge, RISING);

		// ... but keep the latter on hold
		suspendClockInterrupt ();	
#else
		EIMSK |= (1 << INT0);
#endif

		interrupts ();
	}
}

/** \brief Disable CD32 controller support
 * 
 * CD32 mode will no longer be entered automatically after this function has
 * been called.
 */
inline void disableCD32Trigger () {
	// Disable both interrupts, as this might happen halfway during a shift
#ifndef SUPER_OPTIMIZE
	noInterrupts ();
	detachInterrupt (digitalPinToInterrupt (PIN_PADMODE));
	detachInterrupt (digitalPinToInterrupt (PIN_BTNREGCLK));
	interrupts ();
#else
	EIMSK &= ~((1 << INT1) | (1 << INT0));
#endif
}

/** \brief Clear controller configurations
 * 
 * All controller configuration will be reset so that:
 * - Square is button 1
 * - Cross is button 2
 * - All other buttons are inactive
 * 
 * The programming function can then be used to map any button as desired.
 */
void clearConfigurations () {
	debugln (F("Clearing controllerConfigs"));
	memset (controllerConfigs, 0x00, sizeof (controllerConfigs));
	for (byte i = 0; i < PSX_BUTTONS_NO; ++i) {
		ControllerConfiguration& config = controllerConfigs[i];
		//~ memset (&config, 0x00, sizeof (ControllerConfiguration));
		config.buttonMappings[psxButtonToIndex (PSB_SQUARE)].b1 = true;
		config.buttonMappings[psxButtonToIndex (PSB_CROSS)].b2 = true;
	}
}

/** \brief Calculate a CRC of controller configurations
 * 
 * Used to validate the controller configurations after they have been loaded
 * from EEPROM.
 * 
 * \return The calculated CRC
 */
uint16_t calculateConfigCrc () {
	uint16_t crc = 0x4242;
#ifndef DISABLE_EEPROM
	uint8_t *data = (uint8_t *) controllerConfigs;
	for (word i = 0; i < sizeof (controllerConfigs); ++i) {
		crc = _crc16_update (crc, data[i]);
	}
#endif
	
	return crc;
}

/** \brief Load controller configurations from EEPROM
 * 
 * If the loaded configurations are not valid, they are cleared.
 * 
 * \return True if the loaded configurations are valid, false otherwise
 */
boolean loadConfigurations () {
	boolean ret = false;

#ifndef DISABLE_EEPROM
	debug (F("Size of controllerConfigs is "));
	debugln (sizeof (controllerConfigs));
	
	EEPROM.get (4, controllerConfigs);
	
	// Validation
	uint16_t goodCrc;
	EEPROM.get (2, goodCrc);
	uint16_t crc = calculateConfigCrc ();
	if (crc == goodCrc) {
		debugln (F("CRCs match"));
		ret = true;
	} else {
		debugln (F("CRCs do not match"));
		clearConfigurations ();
	}
#endif
	
	return ret;
}

//! \brief Save controller configurations to EEPROM
void saveConfigurations () {
#ifndef DISABLE_EEPROM
	debugln (F("Saving controllerConfigs"));
	
	EEPROM.put (4, controllerConfigs);
	
	// CRC
	uint16_t crc = calculateConfigCrc ();
	EEPROM.put (2, crc);
#endif
}

void setup () {
	dstart (115200);
	debugln (F("Starting up..."));

	// Prepare leds
	fastPinMode (PIN_LED_PAD_OK, OUTPUT);
	fastPinMode (PIN_LED_MODE, OUTPUT);

	/* Load custom mappings from EEPROM, this will also initialize them if
	 * EEPROM data is invalid
	 */
	loadConfigurations ();

#ifdef SUPER_OPTIMIZE
	/* Prepare interrupts: INT0 is triggered by pin 2, i.e. PIN_PADMODE, so it
	 * must be triggered on CHANGE.
	 */
	EICRA |= (1 << ISC00);
	EICRA &= ~(1 << ISC01);		// Probably redundant

	/* INT1 is triggered by pin 3, i.e. PIN_BTNREGCLK/PIN_BTN1, and we want that
	 * triggered by RISING edges. Actually we should care about falling edges,
	 * but since it will take us some time to react to the interrupt, we start
	 * in advance ;).
	 */
	EICRA |= (1 << ISC11) | (1 << ISC10);

	// Interrupts are not activated here, preparation is enough :)
#endif

#ifdef ENABLE_ANALOG_SUPPORT
	// Analog support enabled, let's see if the AD5242 is actually installed
	if (variableResistor.begin ()) {
		haveAnalogCapability = true;
		debugln (F("AD5242 chip found"));

		/* This means that R12 is 1M, let's parallel some resistance and turn it
		 * about 10k
		 */
		variableResistor.setOutputs (0, 1);		// Bring out of shutdown
		delay (200);		// Give digipot time to startup fully
		variableResistor.setValuePoint (AD5242_RDAC::RDAC2, RDAC_PULLUP_VALUE);

		// Same goes for the pull-up on pin 5/POTX/PIN_PADMODE, parallel to R17
		fastPinMode (PIN_PADMODE, INPUT);
		variableResistor.setValuePoint (AD5242_RDAC::RDAC1, RDAC_PULLUP_VALUE);

#ifdef ENABLE_SERIAL_DEBUG
		byte r1, r2;
		variableResistor.read (r1, r2);
		debug (F("Readback AD5242 values = "));
		debug (r1);
		debug (F(", "));
		debugln (r2);
#endif
	} else {
		/* This pin tells us when to toggle in/out of CD32 mode, and it will always
		 * be an input
		 */
		fastPinMode (PIN_PADMODE, INPUT_PULLUP);
	
		debugln (F("AD5242 chip NOT found, disabling analog capability"));
	}
#else
	/* This pin tells us when to toggle in/out of CD32 mode, and it will always
	 * be an input
	 */
	fastPinMode (PIN_PADMODE, INPUT_PULLUP);
#endif

#ifdef ENABLE_INSTRUMENTATION
	// Prepare pins for instrumentation
	fastPinMode (PIN_INTERRUPT_TIMING, OUTPUT);
	fastPinMode (PIN_CD32MODE, OUTPUT);
#endif
	
	// Start polling for controller
	*state = ST_NO_CONTROLLER;
	
	// Give wireless PS2 module some time to startup, before configuring it
	delay (300);
}

/** \brief Switch from Mouse mode to Joystick mode
 * 
 * This function set pins directions and does whatever else is necessary to
 * switch from Mouse mode to Joystick mode.
 * 
 * It is also used at startup to enter Joystick mode for the first time.
 */
void mouseToJoystick () {
	debugln (F("Mouse -> Joystick"));
	
	// All direction pins to Hi-Z without pull-up
	fastDigitalWrite (PIN_UP, LOW);
	fastPinMode (PIN_UP, INPUT);
	fastDigitalWrite (PIN_DOWN, LOW);
	fastPinMode (PIN_DOWN, INPUT);
	fastDigitalWrite (PIN_LEFT, LOW);
	fastPinMode (PIN_LEFT, INPUT);
	fastDigitalWrite (PIN_RIGHT, LOW);
	fastPinMode (PIN_RIGHT, INPUT);
	
	/* These should already be setup correctly, but since we use this function
	 * to switch from ST_INIT to ST_JOYSTICK as well...
	 */
	fastDigitalWrite (PIN_BTN1, LOW);
	fastPinMode (PIN_BTN1, INPUT);
	fastDigitalWrite (PIN_BTN2, LOW);
	fastPinMode (PIN_BTN2, INPUT);
	
	// Be ready to switch to ST_CD32
	enableCD32Trigger ();
}

/** \brief Switch from Joystick mode to Mouse mode
 * 
 * This function set pins directions and does whatever else is necessary to
 * switch from Joystick mode to Mouse mode.
 */
void joystickToMouse () {
	debugln (F("Joystick -> Mouse"));

	// When in mouse mode, we can't switch to CD32 mode
	disableCD32Trigger ();
	
	// Direction pins must be outputs
	fastPinMode (PIN_UP, OUTPUT);
	fastPinMode (PIN_DOWN, OUTPUT);
	fastPinMode (PIN_LEFT, OUTPUT);
	fastPinMode (PIN_RIGHT, OUTPUT);
}

/** \brief Switch from CD32 mode to Mouse mode
 * 
 * This function set pins directions and does whatever else is necessary to
 * switch from CD32 mode to Mouse mode.
 */
void cd32ToMouse () {
	debugln (F("CD32 -> Mouse"));

	disableCD32Trigger ();	// Stops both interrupts
	
	// Direction pins must be outputs
	fastPinMode (PIN_UP, OUTPUT);
	fastPinMode (PIN_DOWN, OUTPUT);
	fastPinMode (PIN_LEFT, OUTPUT);
	fastPinMode (PIN_RIGHT, OUTPUT);

	// Buttons must be ready for open-collector emulation
	fastDigitalWrite (PIN_BTN1, LOW);
	fastPinMode (PIN_BTN1, INPUT);
	fastDigitalWrite (PIN_BTN2, LOW);
	fastPinMode (PIN_BTN2, INPUT);
}

#ifdef ENABLE_ANALOG_SUPPORT
void digitalToAnalog () {
	debugln (F("Digital -> Analog"));

	// We'll ned to drive PotX, let's avoid triggering CD32 mode
	disableCD32Trigger ();

	// PotX and PotY will be drive by AD5242, don't interfere
	fastDigitalWrite (PIN_POTX, LOW);
	fastPinMode (PIN_POTX, INPUT);
	fastDigitalWrite (PIN_POTY, LOW);
	fastPinMode (PIN_POTY, INPUT);

	// Not really necessary...
	variableResistor.resetToMid (AD5242_RDAC::RDAC1);
	variableResistor.resetToMid (AD5242_RDAC::RDAC2);

	/* These are probably redundant, but let's make direction pins ready for
	 * open-collector emulation, as there are used for buttons in analog mode
	 */
	//~ fastDigitalWrite (PIN_UP, LOW);
	//~ fastPinMode (PIN_UP, INPUT);
	//~ fastDigitalWrite (PIN_DOWN, LOW);
	//~ fastPinMode (PIN_DOWN, INPUT);
	//~ fastDigitalWrite (PIN_LEFT, LOW);
	//~ fastPinMode (PIN_LEFT, INPUT);
	//~ fastDigitalWrite (PIN_RIGHT, LOW);
	//~ fastPinMode (PIN_RIGHT, INPUT);
}

void analogToDigital () {
	debugln (F("Analog -> Digital"));

	// PotX is pin 5, used for Atari/CD32 mode
	fastDigitalWrite (PIN_POTX, LOW);
	fastPinMode (PIN_POTX, INPUT);
	variableResistor.setValuePoint (AD5242_RDAC::RDAC1, RDAC_PULLUP_VALUE);

	// PotY is pin 9, used for button 2 in open-collector emulation
	fastDigitalWrite (PIN_POTY, LOW);
	fastPinMode (PIN_POTY, INPUT);
	variableResistor.setValuePoint (AD5242_RDAC::RDAC2, RDAC_PULLUP_VALUE);

#ifdef ENABLE_SERIAL_DEBUG
	byte r1, r2;
	variableResistor.read (r1, r2);
	debug (F("Readback AD5242 values = "));
	debug (r1);
	debug (F(", "));
	debugln (r2);
#endif

	/* These are probably redundant, but let's make direction pins ready for
	 * open-collector emulation, as there are used for buttons in analog mode
	 */
	//~ fastDigitalWrite (PIN_UP, LOW);
	//~ fastPinMode (PIN_UP, INPUT);
	//~ fastDigitalWrite (PIN_DOWN, LOW);
	//~ fastPinMode (PIN_DOWN, INPUT);
	//~ fastDigitalWrite (PIN_LEFT, LOW);
	//~ fastPinMode (PIN_LEFT, INPUT);
	//~ fastDigitalWrite (PIN_RIGHT, LOW);
	//~ fastPinMode (PIN_RIGHT, INPUT);

	// Be ready to switch to ST_CD32
	enableCD32Trigger ();
}
#endif

/** \brief Report a button as pressed on the DB-9 port
 * 
 * Output pins on the DB-9 port are driven in open-collector style, so that we
 * are compatible with the C64 too.
 *
 * Note that LOW is implicit when switching over from INPUT without pull-ups.
 * 
 * This function might look a bit silly, but it is written this way so that it
 * is translated to very efficient code (basically a single ASM instruction!) by
 * using the \a DigitalIO library and with the switched pin being known at
 * compile time.
 * 
 * \sa buttonRelease()
 * 
 * \param[in] pin Pin corresponding to the button to be pressed
 */
inline void buttonPress (byte pin) {
	switch (pin) {
		case PIN_UP:
			fastPinMode (PIN_UP, OUTPUT);
			break;
		case PIN_DOWN:
			fastPinMode (PIN_DOWN, OUTPUT);
			break;
		case PIN_LEFT:
			fastPinMode (PIN_LEFT, OUTPUT);
			break;
		case PIN_RIGHT:
			fastPinMode (PIN_RIGHT, OUTPUT);
			break;
		case PIN_BTN1:
			fastPinMode (PIN_BTN1, OUTPUT);
			break;
		case PIN_BTN2:
			fastPinMode (PIN_BTN2, OUTPUT);
			break;
	}
}

/** \brief Report a button as released on the DB-9 port
 * 
 * \sa buttonPress()
 * 
 * \param[in] pin Pin corresponding to the button to be pressed
 */
inline void buttonRelease (byte pin) {
	// Switch to Hi-Z
	switch (pin) {
		case PIN_UP:
			fastPinMode (PIN_UP, INPUT);
			break;
		case PIN_DOWN:
			fastPinMode (PIN_DOWN, INPUT);
			break;
		case PIN_LEFT:
			fastPinMode (PIN_LEFT, INPUT);
			break;
		case PIN_RIGHT:
			fastPinMode (PIN_RIGHT, INPUT);
			break;
		case PIN_BTN1:
			fastPinMode (PIN_BTN1, INPUT);
			break;
		case PIN_BTN2:
			fastPinMode (PIN_BTN2, INPUT);
			break;
	}
}

/** \brief Map horizontal movements of the left analog stick to a
 *         #TwoButtonJoystick
 * 
 * The stick is not considered moved if it moves less than #ANALOG_DEAD_ZONE.
 * 
 * \param[out] j Mapped joystick status
 */
void mapAnalogStickHorizontal (TwoButtonJoystick& j) {
	byte lx, ly;
	
	if (psx.getLeftAnalog (lx, ly)) {				// 0 ... 255
		int8_t deltaLX = lx - ANALOG_IDLE_VALUE;	// --> -127 ... +128
		j.left = deltaLX < -ANALOG_DEAD_ZONE;
		j.right = deltaLX > +ANALOG_DEAD_ZONE;

#ifdef ENABLE_SERIAL_DEBUG
		static int oldx = -1000;
		if (deltaLX != oldx) {
			debug (F("L Analog X = "));
			debugln (deltaLX);
			oldx = deltaLX;
		}
#endif
	}
}

/** \brief Map vertical movements of the left analog stick to a
 *         #TwoButtonJoystick
 * 
 * The stick is not considered moved if it moves less than #ANALOG_DEAD_ZONE.
 * 
 * \param[out] j Mapped joystick status
 */
void mapAnalogStickVertical (TwoButtonJoystick& j) {
	byte lx, ly;
	
	if (psx.getLeftAnalog (lx, ly)) {
		int8_t deltaLY = ly - ANALOG_IDLE_VALUE;
		j.up = deltaLY < -ANALOG_DEAD_ZONE;
		j.down = deltaLY > +ANALOG_DEAD_ZONE;

#ifdef ENABLE_SERIAL_DEBUG
		static int oldy = -1000;
		if (deltaLY != oldy) {
			debug (F("L Analog Y = "));
			debugln (deltaLY);
			oldy = deltaLY;
		}
#endif
	}
}

/** \brief Map PSX controller buttons to two-button joystick according to the
 *         standard mapping
 *
 * This is the default mapping and must be as "simple" as possible, as it will
 * be used when in CD32 mode. Some CD32 games seem to be reading B1/B2 in Atari
 * mode, and the rest of the buttons in CD32 mode. So if we map, for instance,
 * R1 to B1, when you press R1 to achieve Front Right, you'll also get B1, which
 * you don't probably want.
 * 
 * \param[out] j Mapped joystick status
 */
void mapJoystickNormal (TwoButtonJoystick& j) {
	// Use both analog axes
	mapAnalogStickHorizontal (j);
	mapAnalogStickVertical (j);

	// D-Pad is fully functional as well
	j.up |= psx.buttonPressed (PSB_PAD_UP);
	j.down |= psx.buttonPressed (PSB_PAD_DOWN);
	j.left |= psx.buttonPressed (PSB_PAD_LEFT);
	j.right |= psx.buttonPressed (PSB_PAD_RIGHT);

	// Square is button 1
	j.b1 = psx.buttonPressed (PSB_SQUARE);

	// Cross is button 2
	j.b2 = psx.buttonPressed (PSB_CROSS);
}

/** \brief Map PSX controller buttons to two-button joystick according to Racing
 *         mapping 1
 * 
 * \param[out] j Mapped joystick status
 */
void mapJoystickRacing1 (TwoButtonJoystick& j) {
	// Use analog's horizontal axis to steer, ignore vertical
	mapAnalogStickHorizontal (j);

	// D-Pad L/R can also be used
	j.left |= psx.buttonPressed (PSB_PAD_LEFT);
	j.right |= psx.buttonPressed (PSB_PAD_RIGHT);

	// Use D-Pad U/Square to accelerate and D/Cross to brake
	j.up = psx.buttonPressed (PSB_PAD_UP) || psx.buttonPressed (PSB_SQUARE);
	j.down = psx.buttonPressed (PSB_PAD_DOWN) || psx.buttonPressed (PSB_CROSS);
	
	/* Games probably did not expect up + down at the same time, so when
	 * braking, don't accelerate
	 */
	if (j.down)
		j.up = false;

	// Triangle/Rx are button 1
	j.b1 = psx.buttonPressed (PSB_TRIANGLE) || psx.buttonPressed (PSB_R1) || psx.buttonPressed (PSB_R2) || psx.buttonPressed (PSB_R3);

	// Circle/Lx are button 2
	j.b2 = psx.buttonPressed (PSB_CIRCLE) || psx.buttonPressed (PSB_L1) || psx.buttonPressed (PSB_L2) || psx.buttonPressed (PSB_L3);
}

/** \brief Map PSX controller buttons to two-button joystick according to Racing
 *         mapping 2
 * 
 * \param[out] j Mapped joystick status
 */
void mapJoystickRacing2 (TwoButtonJoystick& j) {
	// Use analog's horizontal axis to steer, ignore vertical
	mapAnalogStickHorizontal (j);

	// D-Pad L/R can also be used
	j.left |= psx.buttonPressed (PSB_PAD_LEFT);
	j.right |= psx.buttonPressed (PSB_PAD_RIGHT);

	// Use D-Pad U/R1/R2 to accelerate and D/Cross/L1/L2 to brake
	j.up = psx.buttonPressed (PSB_PAD_UP) || psx.buttonPressed (PSB_R1) || psx.buttonPressed (PSB_R2);
	j.down = psx.buttonPressed (PSB_PAD_DOWN) || psx.buttonPressed (PSB_CROSS) || psx.buttonPressed (PSB_L1) || psx.buttonPressed (PSB_L2);

	/* Games probably did not expect up + down at the same time, so when
	 * braking, don't accelerate
	 */
	if (j.down)
		j.up = false;

	// Square/R3 are button 1
	j.b1 = psx.buttonPressed (PSB_SQUARE) || psx.buttonPressed (PSB_R3);

	// Triangle/L3 are button 2
	j.b2 = psx.buttonPressed (PSB_TRIANGLE) || psx.buttonPressed (PSB_L3);
}

/** \brief Map PSX controller buttons to two-button joystick according to
 *         Platform mapping
 * 
 * \param[out] j Mapped joystick status
 */
void mapJoystickPlatform (TwoButtonJoystick& j) {
	// Use horizontal analog axis fully, but only down on vertical
	mapAnalogStickHorizontal (j);
	mapAnalogStickVertical (j);

	// D-Pad is fully functional
	j.up = psx.buttonPressed (PSB_PAD_UP);		// Note the '=', will override analog UP
	j.down |= psx.buttonPressed (PSB_PAD_DOWN);
	j.left |= psx.buttonPressed (PSB_PAD_LEFT);
	j.right |= psx.buttonPressed (PSB_PAD_RIGHT);

	// Cross is up/jump
	j.up |= psx.buttonPressed (PSB_CROSS);

	// Square/Rx are button 1
	j.b1 = psx.buttonPressed (PSB_SQUARE) || psx.buttonPressed (PSB_R1) || psx.buttonPressed (PSB_R2) || psx.buttonPressed (PSB_R3);

	// Triangle/Lx are button 2
	j.b2 = psx.buttonPressed (PSB_TRIANGLE) || psx.buttonPressed (PSB_L1) || psx.buttonPressed (PSB_L2) || psx.buttonPressed (PSB_L3);
}

#ifdef ENABLE_ANALOG_SUPPORT

/** \brief Map PSX controller to analog joystick (Left stick)
 * 
 * \param[out] j Mapped joystick status
 */
void mapJoystickAnalogLeft (AnalogJoystick& j) {
	byte x, y;
	
	if (psx.getLeftAnalog (x, y)) {				// 0 ... 255
		j.analogX = x;
		j.analogY = y;

#ifdef ENABLE_SERIAL_DEBUG
		static int oldx = -1000;
		static int oldy = -1000;

		if (x != oldx) {
			debug (F("L Analog X = "));
			debugln (x);
			oldx = x;
		}

		if (y != oldy) {
			debug (F("L Analog Y = "));
			debugln (y);
			oldy = y;
		}
#endif
	}
	
	// Square/Rx are button 1
	j.b1 = psx.buttonPressed (PSB_SQUARE) || psx.buttonPressed (PSB_R1) || psx.buttonPressed (PSB_R2) || psx.buttonPressed (PSB_R3);

	// Triangle/Lx are button 2, which is reported on pin 4 (i.e.: right)
	j.b2 = psx.buttonPressed (PSB_CROSS) || psx.buttonPressed (PSB_L1) || psx.buttonPressed (PSB_L2) || psx.buttonPressed (PSB_L3);

	// AnaCal supports 4 buttons, so give them some meaning
	j.b3 = psx.buttonPressed (PSB_CIRCLE);
	j.b4 = psx.buttonPressed (PSB_TRIANGLE);
}

/** \brief Map PSX controller to analog joystick (Right stick)
 * 
 * \param[out] j Mapped joystick status
 */
void mapJoystickAnalogRight (AnalogJoystick& j) {
	byte x, y;
	
	if (psx.getRightAnalog (x, y)) {				// 0 ... 255
		j.analogX = x;
		j.analogY = y;

#ifdef ENABLE_SERIAL_DEBUG
		static int oldx = -1000;
		static int oldy = -1000;

		if (x != oldx) {
			debug (F("L Analog X = "));
			debugln (x);
			oldx = x;
		}

		if (y != oldy) {
			debug (F("L Analog Y = "));
			debugln (y);
			oldy = y;
		}
#endif
	}
	
	// Square/Rx are button 1
	j.b1 = psx.buttonPressed (PSB_SQUARE) || psx.buttonPressed (PSB_R1) || psx.buttonPressed (PSB_R2) || psx.buttonPressed (PSB_R3);

	// Triangle/Lx are button 2, which is reported on pin 4 (i.e.: right)
	j.b2 = psx.buttonPressed (PSB_CROSS) || psx.buttonPressed (PSB_L1) || psx.buttonPressed (PSB_L2) || psx.buttonPressed (PSB_L3);

	// AnaCal supports 4 buttons, so give them some meaning
	j.b3 = psx.buttonPressed (PSB_CIRCLE);
	j.b4 = psx.buttonPressed (PSB_TRIANGLE);
}

/** \brief Map PSX controller to analog joystick (Left stick for horizontal
 *         axis, right stick for vertical axis)
 * 
 * \param[out] j Mapped joystick status
 */
void mapJoystickAnalogLHRV (AnalogJoystick& j) {
	byte lx, ly, rx, ry;
	
	if (psx.getLeftAnalog (lx, ly) && psx.getRightAnalog (rx, ry)) {
		j.analogX = lx;
		j.analogY = ry;

#ifdef ENABLE_SERIAL_DEBUG
		static int oldx = -1000;
		static int oldy = -1000;

		if (lx != oldx) {
			debug (F("L Analog X = "));
			debugln (lx);
			oldx = lx;
		}

		if (ry != oldy) {
			debug (F("R Analog Y = "));
			debugln (ry);
			oldy = ry;
		}
#endif
	}
	
	// Square/Rx are button 1
	j.b1 = psx.buttonPressed (PSB_SQUARE) || psx.buttonPressed (PSB_R1) || psx.buttonPressed (PSB_R2) || psx.buttonPressed (PSB_R3);

	// Triangle/Lx are button 2, which is reported on pin 4 (i.e.: right)
	j.b2 = psx.buttonPressed (PSB_CROSS) || psx.buttonPressed (PSB_L1) || psx.buttonPressed (PSB_L2) || psx.buttonPressed (PSB_L3);

	// AnaCal supports 4 buttons, so give them some meaning
	j.b3 = psx.buttonPressed (PSB_CIRCLE);
	j.b4 = psx.buttonPressed (PSB_TRIANGLE);
}

/** \brief Map PSX controller to analog joystick (Left stick for vertical
 *         axis, right stick for horizontal axis)
 * 
 * \param[out] j Mapped joystick status
 */
void mapJoystickAnalogLVRH (AnalogJoystick& j) {
	byte lx, ly, rx, ry;
	
	if (psx.getLeftAnalog (lx, ly) && psx.getRightAnalog (rx, ry)) {
		j.analogX = rx;
		j.analogY = ly;

#ifdef ENABLE_SERIAL_DEBUG
		static int oldx = -1000;
		static int oldy = -1000;

		if (rx != oldx) {
			debug (F("R Analog X = "));
			debugln (rx);
			oldx = rx;
		}

		if (ly != oldy) {
			debug (F("L Analog Y = "));
			debugln (ly);
			oldy = ly;
		}
#endif
	}
	
	// Square/Rx are button 1
	j.b1 = psx.buttonPressed (PSB_SQUARE) || psx.buttonPressed (PSB_R1) || psx.buttonPressed (PSB_R2) || psx.buttonPressed (PSB_R3);

	// Triangle/Lx are button 2, which is reported on pin 4 (i.e.: right)
	j.b2 = psx.buttonPressed (PSB_CROSS) || psx.buttonPressed (PSB_L1) || psx.buttonPressed (PSB_L2) || psx.buttonPressed (PSB_L3);

	// AnaCal supports 4 buttons, so give them some meaning
	j.b3 = psx.buttonPressed (PSB_CIRCLE);
	j.b4 = psx.buttonPressed (PSB_TRIANGLE);
}

#endif	// ENABLE_ANALOG_SUPPORT

/** \brief Map PSX controller buttons to two-button joystick according to the
 *         current Custom mapping
 * 
 * \param[out] j Mapped joystick status
 */
void mapJoystickCustom (TwoButtonJoystick& j) {
	// Use both analog axes fully
	mapAnalogStickHorizontal (j);
	mapAnalogStickVertical (j);

	// D-Pad is fully functional as well
	j.up |= psx.buttonPressed (PSB_PAD_UP);
	j.down |= psx.buttonPressed (PSB_PAD_DOWN);
	j.left |= psx.buttonPressed (PSB_PAD_LEFT);
	j.right |= psx.buttonPressed (PSB_PAD_RIGHT);

	for (byte i = 0; i < PSX_BUTTONS_NO; ++i) {
		PsxButton button = static_cast<PsxButton> (1 << i);
		if (isButtonMappable (button) && psx.buttonPressed (button)) {
			byte buttonIdx = psxButtonToIndex (button);
			mergeButtons (j, currentCustomConfig -> buttonMappings[buttonIdx]);
		}
	}
}

/** \brief Merge two #TwoButtonJoystick's
 * 
 * Every button that is pressed in either \a src or \a dest will end up pressed
 * in \a dest.
 * 
 * \param[inout] dest Destination
 * \param[in] src Source
 */
void mergeButtons (TwoButtonJoystick& dest, const TwoButtonJoystick& src) {
	/* This is what we need to do:
	 * dest.up |= src.up;
	 * dest.down |= src.down;
	 * dest.left |= src.left;
	 * dest.right |= src.right;
	 * dest.b1 |= src.b1;
	 * dest.b2 |= src.b2;
	 *
	 * And this is the way we're doing it to be faaaast and save flash:
	 */
	byte *bd = reinterpret_cast<byte *> (&dest);
	const byte *sd = reinterpret_cast<const byte *> (&src);
	*bd |= *sd;
}

/** \brief Flash the Mode LED
 * 
 * \param[in] n Desired number of flashes
 */
void flashLed (byte n) {
	for (byte i = 0; i < n; ++i) {
		fastDigitalWrite (PIN_LED_MODE, HIGH);
		delay (40);
		fastDigitalWrite (PIN_LED_MODE, LOW);
		delay (80);
	}
}

/** \brief Check if the left analog stick has been moved
 * 
 * The stick is not considered moved if it moves less than #ANALOG_DEAD_ZONE.
 * 
 * \sa rightAnalogMoved
 * 
 * \param[out] x Movement on the horizontal axis [-127 ... 127]
 * \param[out] y Movement on the vertical axis [-127 ... 127]
 * \return True if the stick is not in the center position, false otherwise
 */
boolean leftAnalogMoved (int8_t& x, int8_t& y) {
	boolean ret = false;
	byte lx, ly;
	
	if (psx.getLeftAnalog (lx, ly)) {				// [0 ... 255]
		int8_t deltaLX = lx - ANALOG_IDLE_VALUE;	// [-128 ... 127]
		uint8_t deltaLXabs = abs (deltaLX);
		if (deltaLXabs > ANALOG_DEAD_ZONE) {
			x = deltaLX;
			if (x == -128)
				x = -127;
			ret = true;
		} else {
			x = 0;
		}
		
		int8_t deltaLY = ly - ANALOG_IDLE_VALUE;
		uint8_t deltaLYabs = abs (deltaLY);
		if (deltaLYabs > ANALOG_DEAD_ZONE) {
			ly = deltaLY;
			if (y == -128)
				y = -127;
			ret = true;
		} else {
			y = 0;
		}
		
#ifdef ENABLE_SERIAL_DEBUG
		if (ret) {
			static int oldx = -1000;
			if (x != oldx) {
				debug (F("L Analog X = "));
				debugln (x);
				oldx = x;
			}

			static int oldy = -1000;
			if (y != oldy) {
				debug (F("L Analog Y = "));
				debugln (y);
				oldy = y;
			}
		}
#endif
	}
	
	return ret;
}

/** \brief Check if the right analog stick has been moved
 * 
 * The stick is not considered moved if it moves less than #ANALOG_DEAD_ZONE.
 * 
 * \sa leftAnalogMoved
 * 
 * \param[out] x Movement on the horizontal axis [-127 ... 127]
 * \param[out] y Movement on the vertical axis [-127 ... 127]
 * \return True if the stick is not in the center position, false otherwise
 */
boolean rightAnalogMoved (int8_t& x, int8_t& y) {
	boolean ret = false;
	byte rx, ry;
	
	if (psx.getRightAnalog (rx, ry)) {				// [0 ... 255]
		int8_t deltaRX = rx - ANALOG_IDLE_VALUE;	// [-128 ... 127]
		uint8_t deltaRXabs = abs (deltaRX);
		if (deltaRXabs > ANALOG_DEAD_ZONE) {
			x = deltaRX;
			if (x == -128)
				x = -127;
			ret = true;
		} else {
			x = 0;
		}
		
		int8_t deltaRY = ry - ANALOG_IDLE_VALUE;
		uint8_t deltaRYabs = abs (deltaRY);
		if (deltaRYabs > ANALOG_DEAD_ZONE) {
			y = deltaRY;
			if (y == -128)
				y = -127;
			ret = true;
		} else {
			y = 0;
		}
		
#ifdef ENABLE_SERIAL_DEBUG
		if (ret) {
			static int oldx = -1000;
			if (x != oldx) {
				debug (F("R Analog X = "));
				debugln (x);
				oldx = x;
			}

			static int oldy = -1000;
			if (y != oldy) {
				debug (F("R Analog Y = "));
				debugln (y);
				oldy = y;
			}
		}
#endif
	}
	
	return ret;
}

/** \brief Update the output direction pins
 * 
 * This functions updates the status of the 4 directional pins of the DB-9 port.
 * It does so after calling the current joystick mapping function, whose output
 * will also be exported in \a j.
 * 
 * It also updates \a buttonsLive.
 *
 * \param[out] j Mapped joystick status
 */
void handleJoystickDirections (TwoButtonJoystick& j) {
	// Call button mapping function
	joyMappingFunc (j);

#ifdef ENABLE_SERIAL_DEBUG
	static TwoButtonJoystick oldJoy = {false, false, false, false, false, false};

	if (memcmp (&j, &oldJoy, sizeof (TwoButtonJoystick)) != 0) {
		debug (F("Sending to DB-9: "));
		dumpJoy (j);
		oldJoy = j;
	}
#endif

	// Make mapped buttons affect the actual pins
	if (j.up) {
		buttonPress (PIN_UP);
	} else {
		buttonRelease (PIN_UP);
	}

	if (j.down) {
		buttonPress (PIN_DOWN);
	} else {
		buttonRelease (PIN_DOWN);
	}

	if (j.left) {
		buttonPress (PIN_LEFT);
	} else {
		buttonRelease (PIN_LEFT);
	}

	if (j.right) {
		buttonPress (PIN_RIGHT);
	} else {
		buttonRelease (PIN_RIGHT);
	}

	/* Map buttons, working on a temporary variable to avoid the sampling
	 * interrupt to happen while we are filling in button statuses and catch a
	 * value that has not yet been fully populated.
	 *
	 * Note that 0 means pressed and that MSB must be 1 for the ID
	 * sequence.
	 */
	byte buttonsTmp = 0xFF;

	if (psx.buttonJustPressed (PSB_SELECT)) {
		useAlternativeCd32Mapping = !useAlternativeCd32Mapping;
		flashLed (((byte) useAlternativeCd32Mapping) + 1);	// Flash-saving hack
	}

	if (useAlternativeCd32Mapping) {
		if (psx.buttonPressed (PSB_SQUARE))
			buttonsTmp &= ~BTN_GREEN;

		if (psx.buttonPressed (PSB_CROSS))
			buttonsTmp &= ~BTN_RED;

		if (psx.buttonPressed (PSB_CIRCLE))
			buttonsTmp &= ~BTN_BLUE;

		if (psx.buttonPressed (PSB_TRIANGLE))
			buttonsTmp &= ~BTN_YELLOW;
	} else {
		if (psx.buttonPressed (PSB_TRIANGLE))
			buttonsTmp &= ~BTN_GREEN;

		if (psx.buttonPressed (PSB_SQUARE))
			buttonsTmp &= ~BTN_RED;

		if (psx.buttonPressed (PSB_CROSS))
			buttonsTmp &= ~BTN_BLUE;

		if (psx.buttonPressed (PSB_CIRCLE))
			buttonsTmp &= ~BTN_YELLOW;
	}		

	if (psx.buttonPressed (PSB_START))
		buttonsTmp &= ~BTN_START;

	if (psx.buttonPressed (PSB_L1) || psx.buttonPressed (PSB_L2) || psx.buttonPressed (PSB_L3))
		buttonsTmp &= ~BTN_FRONT_L;

	if (psx.buttonPressed (PSB_R1) || psx.buttonPressed (PSB_R2) || psx.buttonPressed (PSB_R3))
		buttonsTmp &= ~BTN_FRONT_R;

	// Atomic operation, interrupt either happens before or after this
	*buttonsLive = buttonsTmp;
}

/** \brief Update the output fire button pins when in joystick mode
 * 
 * This functions updates the status of the 2 fire button pins of the DB-9 port.
 * It shall only be called when state is ST_JOYSTICK.
 *
 * \param[in] j Mapped joystick status, as returned by
 *              handleJoystickDirections().
 */
void handleJoystickButtons (const TwoButtonJoystick& j) {
	/* If the interrupt that switches us to CD32 mode is
	 * triggered while we are here we might end up setting pin states after
	 * we should have relinquished control of the pins, so let's avoid this
	 * disabling interrupts, we will handle them in a few microseconds.
	 */
	noInterrupts ();

	/* Ok, this breaks the state machine abstraction a bit, but we *have* to do
	 * this check now, as the interrupt that makes us switch to ST_CD32 might
	 * have occurred after this function was called but before we disabled
	 * interrupts, and we absolutely have to avoid modifying pin
	 * directions/states if the ISR has already been called.
	 */
	if (*state == ST_JOYSTICK) {
		if (j.b1) {
			buttonPress (PIN_BTN1);
		} else {
			buttonRelease (PIN_BTN1);
		}

		if (!c64Mode) {
			if (j.b2) {
				buttonPress (PIN_BTN2);
			} else {
				buttonRelease (PIN_BTN2);
			}
		} else {
			// C64 works the opposite way
			if (j.b2) {
				buttonRelease (PIN_BTN2);
			} else {
				buttonPress (PIN_BTN2);
			}
		}
	}
	
	interrupts ();
}

/** \brief Update the primary output fire button pins when in CD32 mode
 * 
 * This functions updates the status of the 2 main fire buttons inbetween two
 * consecutive CD32-style readings. It might seem counter-intuitive, but many
 * games (including lowlevel.library, I think!) read the state of the two main
 * buttons this way, rather than extracting them from the full 7-button reply,
 * don't ask me why. See \a Banshee, for instance.
 * 
 * So we need a different function that does not perform button mapping as when
 * in 2-button joystick mode, but that rather uses the current CD32 mapping.
 * This means it shall also be coherent with what onPadModeChange() is doing
 * when PIN_PADMODE goes high.
 * 
 * Of course, this function shall only be called when state is ST_CD32.
 */
void handleJoystickButtonsTemp () {
	// Use the same logic as in handleJoystickButtons()
	noInterrupts ();

	if (*state == ST_JOYSTICK_TEMP) {
		/* Relying on buttonsLive guarantees we do the right thing even when
		 * useAlternativeCd32Mapping is true
		 */
		if (!(*buttonsLive & BTN_RED)) {
			buttonPress (PIN_BTN1);
		} else {
			buttonRelease (PIN_BTN1);
		}

		if (!(*buttonsLive & BTN_BLUE)) {
			buttonPress (PIN_BTN2);
		} else {
			buttonRelease (PIN_BTN2);
		}
	}
	
	interrupts ();
}

#ifdef ENABLE_ANALOG_SUPPORT

/** \brief Update the output pins (Analog mode)
 * 
 * This functions updates the status of all pins of the DB-9 port. It does so
 * after calling the current analog joystick mapping function.
 */
void handleAnalogJoystick () {
	AnalogJoystick j;
	byte x, y;
	
	// Call mapping function
	analogJoyMappingFunc (j);

#ifdef ENABLE_SERIAL_DEBUG
	//~ static AnalogJoystick oldJoy = {0, 0, false, false, false, false};

	//~ if (memcmp (&j, &oldJoy, sizeof (AnalogJoystick)) != 0) {
		//~ debug (F("Sending to DB-9: "));
		//~ dumpJoy (j);
		//~ oldJoy = j;
	//~ }
#endif

	// Send analog data to digipots: RDAC1 is connected to PotX, RDAC2 to PotY
#ifdef DISABLE_ANALOG_OUTPUT_COMPENSATION
	x = 255 - j.analogX;
	y = 255 - j.analogY;
#else
	x = rcompensated[j.analogX];
	y = rcompensated[j.analogY];
#endif

	if (swapAnalogAxes && x != y) {
		/* Oddly enough, only a few games read the X axis from PotX and the Y
		 * axis from PotY...
		 */
		x ^= y;
		y ^= x;
		x ^= y;
	}

	debug (F("Setting RDAC1,2 to "));
	debug (x);
	debug (F(", "));
	debugln (y);
	variableResistor.setValuePoint (AD5242_RDAC::RDAC1, x);
	variableResistor.setValuePoint (AD5242_RDAC::RDAC2, y);

#ifdef ENABLE_SERIAL_DEBUG
	byte r1, r2;
	variableResistor.read (r1, r2);
	debug (F("Readback AD5242 values = "));
	debug (r1);
	debug (F(", "));
	debugln (r2);
#endif

	// Make mapped buttons affect the actual pins
	if (j.b1) {		// This uses pin 3, i.e.: left
		buttonPress (PIN_LEFT);
	} else {
		buttonRelease (PIN_LEFT);
	}

	if (j.b2) {		// Pin 4, i.e.: right
		buttonPress (PIN_RIGHT);
	} else {
		buttonRelease (PIN_RIGHT);
	}

	if (j.b3) {		// Pin 1, i.e.: up
		buttonPress (PIN_UP);
	} else {
		buttonRelease (PIN_UP);
	}

	if (j.b4) {		// Pin 2, i.e.: down
		buttonPress (PIN_DOWN);
	} else {
		buttonRelease (PIN_DOWN);
	}
}
#endif

/** \brief Update all output pins for Mouse mode
 * 
 * This function updates all the output pins as necessary to emulate mouse
 * movements and button presses. It shall only be called when state is ST_MOUSE.
 */
void handleMouse () {
	static unsigned long tx = 0, ty = 0;
	
	int8_t x, y;
	rightAnalogMoved (x, y);
	
	// Horizontal axis
	if (x != 0) {
		debug (F("x = "));
		debug (x);

		unsigned int period = map (abs (x), ANALOG_DEAD_ZONE, 127, MOUSE_SLOW_DELTA, MOUSE_FAST_DELTA);
		debug (F(" --> period = "));
		debugln (period);

		if (x > 0) {
			// Right
			if (millis () - tx >= period) {
				fastDigitalToggle (PIN_RIGHT);
				tx = millis ();
			}
			
			if (millis () - tx >= period / 2) {
				fastDigitalWrite (PIN_DOWN, !fastDigitalRead (PIN_RIGHT));
			}
		} else {
			// Left
			if (millis () - tx >= period) {
				fastDigitalToggle (PIN_DOWN);
				tx = millis ();
			}
			
			if (millis () - tx >= period / 2) {
				fastDigitalWrite (PIN_RIGHT, !fastDigitalRead (PIN_DOWN));
			}
		}
	}

	// Vertical axis
	if (y != 0) {
		debug (F("y = "));
		debug (y);

		unsigned int period = map (abs (y), ANALOG_DEAD_ZONE, 127, MOUSE_SLOW_DELTA, MOUSE_FAST_DELTA);
		debug (F(" --> period = "));
		debugln (period);

		if (y > 0) {
			// Up
			if (millis () - ty >= period) {
				fastDigitalToggle (PIN_LEFT);
				ty = millis ();
			}
			
			if (millis () - ty >= period / 2) {
				fastDigitalWrite (PIN_UP, !fastDigitalRead (PIN_LEFT));
			}
		} else {
			// Down
			if (millis () - ty >= period) {
				fastDigitalToggle (PIN_UP);
				ty = millis ();
			}
			
			if (millis () - ty >= period / 2) {
				fastDigitalWrite (PIN_LEFT, !fastDigitalRead (PIN_UP));
			}	
		}
	}

	/* Buttons - This won't happen while in CD32 mode, so there's no need to
	 * disable interrupts
	 */
	if (psx.buttonPressed (PSB_L1) || psx.buttonPressed (PSB_L2) || psx.buttonPressed (PSB_L3)) {
		buttonPress (PIN_BTN1);
	} else {
		buttonRelease (PIN_BTN1);
	}

	if (psx.buttonPressed (PSB_R1) || psx.buttonPressed (PSB_R2) || psx.buttonPressed (PSB_R3)) {
		buttonPress (PIN_BTN2);
	} else {
		buttonRelease (PIN_BTN2);
	}
}

/** \brief Debounce button/combo presses
 * 
 * Makes sure that the same button/combo has been pressed steadily for some
 * time.
 * 
 * \sa DEBOUNCE_TIME_BUTTON
 * \sa DEBOUNCE_TIME_COMBO
 * 
 * \param[in] holdTime Time the button/combo must be stable for
 */
PsxButtons debounceButtons (unsigned long holdTime) {
	static PsxButtons oldButtons = PSB_NONE;
	static unsigned long pressedOn = 0;

	PsxButtons ret = PSB_NONE;

	PsxButtons buttons = psx.getButtonWord ();
	if (buttons == oldButtons) {
		if (millis () - pressedOn > holdTime) {
			// Same combo held long enough
			ret = buttons;
		} else {
			// Combo held not long enough (yet)
		}
	} else {
		// Buttons bouncing
		oldButtons = buttons;
		pressedOn = millis ();
	}

	return ret;
}

/** \brief Translate a button combo to what would be sent to the DB-9 port
 * 
 * This is used during programming mode to enter the combo that should be sent
 * whenever a mapped button is pressed.
 * 
 * \param[in] psxButtons PSX controller button combo
 * \param[out] j Two-button joystick configuration corresponding to input
 * \return True if the output contains at least one pressed button
 */
boolean psxButton2Amiga (PsxButtons psxButtons, TwoButtonJoystick& j) {
	memset (&j, 0x00, sizeof (j));
	
	j.up = psx.buttonPressed (psxButtons, PSB_PAD_UP);
	j.down = psx.buttonPressed (psxButtons, PSB_PAD_DOWN);
	j.left = psx.buttonPressed (psxButtons, PSB_PAD_LEFT);
	j.right = psx.buttonPressed (psxButtons, PSB_PAD_RIGHT);
	j.b1 = psx.buttonPressed (psxButtons, PSB_SQUARE);
	j.b2 = psx.buttonPressed (psxButtons, PSB_CROSS);

	return *reinterpret_cast<byte *> (&j);
}

/** \brief Dump a TwoButtonJoystick structure to serial
 * 
 * This function is meant for debugging.
 * 
 * \param[in] j Two-button joystick to be dumped
 */
void dumpJoy (TwoButtonJoystick& j) {
	if (j.up) {
		debug (F("Up "));
	}
	if (j.down) {
		debug (F("Down "));
	}
	if (j.left) {
		debug (F("Left "));
	}
	if (j.right) {
		debug (F("Right "));
	}
	if (j.b1) {
		debug (F("B1 "));
	}
	if (j.b2) {
		debug (F("B2"));
	}
	debugln (F(""));
}

/** \brief Get number of set bits in the binary representation of a number
 * 
 * All hail to Brian Kernighan.
 * 
 * \param[in] n The number
 * \return The number of bits set
 */
unsigned int countSetBits (int n) { 
	unsigned int count = 0; 

	while (n) { 
		n &= n - 1;
		++count; 
	} 

	return count; 
}

/** \brief Check whether a button report contains a mappable button
 * 
 * That means it contains a single button which is not \a SELECT neither one
 * from the D-Pad.
 * 
 * \param[in] b The button to be checked
 * \return True if \b can be mapped, false otherwise
 */
boolean isButtonMappable (PsxButtons b) {
	return countSetBits (b) == 1 &&
	       !psx.buttonPressed (b, PSB_SELECT) &&
	       !psx.buttonPressed (b, PSB_PAD_UP) &&
	       !psx.buttonPressed (b, PSB_PAD_DOWN) &&
	       !psx.buttonPressed (b, PSB_PAD_LEFT) &&
	       !psx.buttonPressed (b, PSB_PAD_RIGHT);
}

/** \brief Check if a PSX button is programmable
 * 
 * \param[in] b The button to be checked
 * \return True if \b is programmable, false otherwise
 */
boolean isButtonProgrammable (PsxButtons b) {
	return psx.buttonPressed (b, PSB_L1) || psx.buttonPressed (b, PSB_L2) ||
	       psx.buttonPressed (b, PSB_R1) || psx.buttonPressed (b, PSB_R2);
}

//! \brief Handle the internal state machine
void stateMachine () {
	static unsigned long stateEnteredTime = 0;
	static unsigned long lastPoll = 0;
	static PsxButton selectComboButton = PSB_NONE;
	static PsxButton programmedButton = PSB_NONE;
	PsxButtons buttons = PSB_NONE;
	TwoButtonJoystick j = {false, false, false, false, false, false};

	/* This is done first since ALL states except NO_CONTROLLER need to poll the
	 * controller first and switch to NO_CONTROLLER if polling failed
	 */
	if (*state != ST_NO_CONTROLLER) {
		// We have a controller and we can poll it
		if (millis () - lastPoll > 1000U / PAD_POLLING_FREQ) {
			if (psx.read ()) {
				dumpButtons (psx.getButtonWord ());
			} else {
				// Polling failed
				debugln (F("Controller lost"));
				*state = ST_NO_CONTROLLER;
				*buttonsLive = 0x7F;		// No ID sequence, all buttons released
			}

			lastPoll = millis ();
		}
	}

	switch (*state) {
		case ST_NO_CONTROLLER:
			/* There's no need to only poll every so often, the function is slow
			 * and will basically time itself just fine
			 */
			if (initPad ()) {
				/* Got a controller! We'll default to joystick mode, so let's
				 * set everything up now. Let's abuse the mouseToJoystick()
				 * function, hope she won't mind :).
				 */
				mouseToJoystick ();
				*state = ST_FIRST_READ;
				stateEnteredTime = 0;
			}
			break;
		case ST_FIRST_READ:
			if (stateEnteredTime == 0) {
				// State was just entered
				stateEnteredTime = millis ();
			} else if (millis () - stateEnteredTime > 500UL) {
				// Timeout, let's move on
				stateEnteredTime = 0;
				*state = ST_JOYSTICK;
			} else if (psx.buttonPressed (PSB_CROSS)) {
				/* CROSS pressed early after controller was plugged in (or the
				 * adapter was powered on), so the user wants to inhibit CD32
				 * mode
				 */
				debugln (F("CROSS pressed at power-up, inhibiting CD32 mode"));
				disableCD32Trigger ();
				inhibitCd32Mode = true;
				stateEnteredTime = 0;
				*state = ST_JOYSTICK;
#ifndef DISABLE_FACTORY_RESET
			} else if (psx.buttonPressed (PSB_SELECT)) {
				stateEnteredTime = 0;
				// SELECT pressed early, user wants to do a factory reset
				debugln (F("SELECT pressed at power-up, starting factory reset"));
				*state = ST_FACTORY_RESET_WAIT_1;
#endif
#ifndef DISABLE_TEST_MODE
			} else if (psx.buttonPressed (PSB_START)) {
				stateEnteredTime = 0;
				// START pressed early, user wants to switch to test mode
				debugln (F("START pressed at power-up, switching to test mode"));
				*state = ST_TEST_MODE;
#endif
			}
			break;
			
		/**********************************************************************
		 * TEST MODE
		 **********************************************************************/
#ifndef DISABLE_TEST_MODE
		case ST_TEST_MODE: {
			int8_t dummy;
			
			buttons = debounceButtons (DEBOUNCE_TIME_BUTTON);
			fastDigitalWrite (PIN_LED_MODE, buttons != PSB_NONE ||
			                                leftAnalogMoved (dummy, dummy) ||
			                                rightAnalogMoved (dummy, dummy));
			break;
		}
#endif
				
		/**********************************************************************
		 * MAIN MODES
		 **********************************************************************/
		case ST_JOYSTICK: {
			int8_t dummy;
			
			if (rightAnalogMoved (dummy, dummy)) {
				// Right analog stick moved, switch to Mouse mode
				joystickToMouse ();
				*state = ST_MOUSE;
			} else if (psx.buttonPressed (PSB_SELECT)) {
				*state = ST_SELECT_HELD;
			} else {
				// Handle normal joystick movements
				handleJoystickDirections (j);
				handleJoystickButtons (j);
			}
			break;
		} case ST_MOUSE:
			if (psx.buttonPressed (PSB_PAD_UP) || psx.buttonPressed (PSB_PAD_DOWN) ||
				psx.buttonPressed (PSB_PAD_LEFT) || psx.buttonPressed (PSB_PAD_RIGHT)) {
				// D-Pad pressed, go back to joystick mode
				mouseToJoystick ();
				*state = ST_JOYSTICK;
			} else {
				handleMouse ();
			}
			break;
		case ST_CD32: {
			int8_t dummy;
			
			if (rightAnalogMoved (dummy, dummy)) {
				// Right analog stick moved, switch to Mouse mode
				cd32ToMouse ();
				*state = ST_MOUSE;
			} else {
				handleJoystickDirections (j);
			}
			stateEnteredTime = 0;
			break;
		} case ST_JOYSTICK_TEMP: {
			handleJoystickDirections (j);
			handleJoystickButtonsTemp ();

			if (stateEnteredTime == 0) {
				// State was just entered
				stateEnteredTime = millis ();
			} else if (millis () - stateEnteredTime > TIMEOUT_CD32_MODE) {
				// CD32 mode was exited once for all
				stateEnteredTime = 0;
				*state = ST_JOYSTICK;
			}
			break;
		}
#ifdef ENABLE_ANALOG_SUPPORT
		case ST_ANALOG:
			if (psx.buttonPressed (PSB_SELECT)) {
				*state = ST_ANALOG_SELECT_HELD;
			} else {
				handleAnalogJoystick ();
			}
			break;
		case ST_ANALOG_SELECT_HELD:
			if (!psx.buttonPressed (PSB_SELECT)) {
				// Select was released
				*state = ST_ANALOG;
			} else if (psx.buttonPressed (PSB_SQUARE)) {
				selectComboButton = PSB_SQUARE;
				*state = ST_ANALOG_SELECT_AND_BTN_HELD;
			} else if (psx.buttonPressed (PSB_TRIANGLE)) {
				selectComboButton = PSB_TRIANGLE;
				*state = ST_ANALOG_SELECT_AND_BTN_HELD;
			} else if (psx.buttonPressed (PSB_CIRCLE)) {
				selectComboButton = PSB_CIRCLE;
				*state = ST_ANALOG_SELECT_AND_BTN_HELD;
			} else if (psx.buttonPressed (PSB_CROSS)) {
				selectComboButton = PSB_CROSS;
				*state = ST_ANALOG_SELECT_AND_BTN_HELD;
			} else if (psx.buttonPressed (PSB_START)) {
				selectComboButton = PSB_START;
				*state = ST_ANALOG_SELECT_AND_BTN_HELD;
			} else if (psx.buttonPressed (PSB_PAD_DOWN)) {
				selectComboButton = PSB_PAD_DOWN;
				*state = ST_ANALOG_SELECT_AND_BTN_HELD;
			}
			break;
		case ST_ANALOG_SELECT_AND_BTN_HELD:
			if (!psx.buttonPressed (PSB_SELECT) || !psx.buttonPressed (selectComboButton)) {
				// Combo released, switch to desired mapping
				*state = ST_ANALOG_ENABLE_MAPPING;
			}
			break;
		case ST_ANALOG_ENABLE_MAPPING:
			// Change button mapping
			switch (selectComboButton) {
				case PSB_SQUARE:
					debugln (F("Setting left analog mapping"));
					analogJoyMappingFunc = mapJoystickAnalogLeft;
					flashLed (JMAP_NORMAL);
					break;
				case PSB_CROSS:
					debugln (F("Setting right analog mapping"));
					analogJoyMappingFunc = mapJoystickAnalogRight;
					flashLed (JMAP_RACING1);
					break;
				case PSB_TRIANGLE:
					debugln (F("Setting LHRV analog mapping"));
					analogJoyMappingFunc = mapJoystickAnalogLHRV;
					flashLed (JMAP_RACING2);
					break;
				case PSB_CIRCLE:
					debugln (F("Setting LVRH analog mapping"));
					analogJoyMappingFunc = mapJoystickAnalogLVRH;
					flashLed (JMAP_PLATFORM);
					break;
				case PSB_START:
					//~ if (swapAnalogAxes) {
						//~ flashLed (2);
					//~ } else {
						//~ flashLed (1);
					//~ }
					debugln (F("Swapping axes"));
					flashLed (((byte) swapAnalogAxes) + 1);	// Flash-saving hack
					swapAnalogAxes = !swapAnalogAxes;
					break;
				case PSB_PAD_DOWN:
					flashLed (2);
					analogToDigital ();
					*state = ST_JOYSTICK;
					break;
				default:
					break;
			}
			
			if (*state == ST_ANALOG_ENABLE_MAPPING) {
				*state = ST_ANALOG;		// Get out!
			}
			
			break;
#endif
				
		/**********************************************************************
		 * SELECT MAPPING/SWITCH TO PROGRAMMING MODE
		 **********************************************************************/
		case ST_SELECT_HELD:
			if (!psx.buttonPressed (PSB_SELECT)) {
				// Select was released
				*state = ST_JOYSTICK;
			} else if (psx.buttonPressed (PSB_SQUARE)) {
				selectComboButton = PSB_SQUARE;
				*state = ST_SELECT_AND_BTN_HELD;
			} else if (psx.buttonPressed (PSB_TRIANGLE)) {
				selectComboButton = PSB_TRIANGLE;
				*state = ST_SELECT_AND_BTN_HELD;
			} else if (psx.buttonPressed (PSB_CIRCLE)) {
				selectComboButton = PSB_CIRCLE;
				*state = ST_SELECT_AND_BTN_HELD;
			} else if (psx.buttonPressed (PSB_CROSS)) {
				selectComboButton = PSB_CROSS;
				*state = ST_SELECT_AND_BTN_HELD;
			} else if (psx.buttonPressed (PSB_L1)) {
				selectComboButton = PSB_L1;
				*state = ST_SELECT_AND_BTN_HELD;
			} else if (psx.buttonPressed (PSB_R1)) {
				selectComboButton = PSB_R1;
				*state = ST_SELECT_AND_BTN_HELD;
			} else if (psx.buttonPressed (PSB_L2)) {
				selectComboButton = PSB_L2;
				*state = ST_SELECT_AND_BTN_HELD;
			} else if (psx.buttonPressed (PSB_R2)) {
				selectComboButton = PSB_R2;
				*state = ST_SELECT_AND_BTN_HELD;
			} else if (psx.buttonPressed (PSB_START)) {
				selectComboButton = PSB_START;
				*state = ST_SELECT_AND_BTN_HELD;
			} else if (psx.buttonPressed (PSB_PAD_UP)) {
				selectComboButton = PSB_PAD_UP;
				*state = ST_SELECT_AND_BTN_HELD;
			}
			break;
		case ST_SELECT_AND_BTN_HELD:
			if (stateEnteredTime == 0) {
				// State was just entered
				stateEnteredTime = millis ();
			} else if (isButtonProgrammable (selectComboButton) && millis () - stateEnteredTime > TIMEOUT_PROGRAMMING_MODE) {
				// Combo kept pressed, enter programming mode
				debug (F("Entering programming mode for "));
				debugln (getButtonName (selectComboButton));
				stateEnteredTime = 0;
				*state = ST_WAIT_SELECT_RELEASE;
			} else if (!psx.buttonPressed (PSB_SELECT) || !psx.buttonPressed (selectComboButton)) {
				// Combo released, switch to desired mapping
				stateEnteredTime = 0;
				*state = ST_ENABLE_MAPPING;
			}
			break;
		case ST_ENABLE_MAPPING:
			// Change button mapping
			switch (selectComboButton) {
				case PSB_SQUARE:
					debugln (F("Setting normal mapping"));
					joyMappingFunc = mapJoystickNormal;
					flashLed (JMAP_NORMAL);
					break;
				case PSB_TRIANGLE:
					debugln (F("Setting Racing1 mapping"));
					joyMappingFunc = mapJoystickRacing1;
					flashLed (JMAP_RACING1);
					break;
				case PSB_CIRCLE:
					debugln (F("Setting Racing2 mapping"));
					joyMappingFunc = mapJoystickRacing2;
					flashLed (JMAP_RACING2);
					break;
				case PSB_CROSS:
					debugln (F("Setting Platform mapping"));
					joyMappingFunc = mapJoystickPlatform;
					flashLed (JMAP_PLATFORM);
					break;
				case PSB_L1:
				case PSB_R1:
				case PSB_L2:
				case PSB_R2: {
					byte configIdx = psxButtonToIndex (selectComboButton);
					if (configIdx < PSX_BUTTONS_NO) {
						debug (F("Setting Custom mapping for controllerConfig "));
						debugln (configIdx);
						currentCustomConfig = &controllerConfigs[configIdx];
						joyMappingFunc = mapJoystickCustom;
						flashLed (JMAP_CUSTOM);
					} else {
						/* Something went wrong, just ignore it and pretend
						 * nothing ever happened
						 */
					}
					break;
				} case PSB_START:
					//~ if (c64Mode) {
						//~ flashLed (2);
					//~ } else {
						//~ flashLed (1);
					//~ }
					flashLed (((byte) c64Mode) + 1);	// Flash-saving hack
					c64Mode = !c64Mode;
					break;
#ifdef ENABLE_ANALOG_SUPPORT
				case PSB_PAD_UP:
					flashLed (1);
					digitalToAnalog ();
					*state = ST_ANALOG;
					break;
#endif
				default:
					// Shouldn't be reached
					break;
			}
			if (*state == ST_ENABLE_MAPPING) {
				*state = ST_JOYSTICK;		// Get out!
			}
			break;
		
		/**********************************************************************
		 * PROGRAMMING
		 **********************************************************************/
		case ST_WAIT_SELECT_RELEASE:
			if (!psx.buttonPressed (PSB_SELECT)) {
				*state = ST_WAIT_BUTTON_PRESS;
			}
			break;
		case ST_WAIT_BUTTON_PRESS:
			if (psx.buttonPressed (PSB_SELECT)) {
				// Exit programming mode
				debugln (F("Leaving programming mode"));
				saveConfigurations ();	// No need to check for changes as this uses EEPROM.update()
				*state = ST_WAIT_SELECT_RELEASE_FOR_EXIT;
			} else {
				buttons = debounceButtons (DEBOUNCE_TIME_BUTTON);
				if (isButtonMappable (buttons)) {
					// Exactly one key pressed, go on
					programmedButton = static_cast<PsxButton> (buttons);
					debug (F("Programming button "));
					debugln (getButtonName (buttons));
					flashLed (3);
					*state = ST_WAIT_BUTTON_RELEASE;
				}
			}
			break;
		case ST_WAIT_BUTTON_RELEASE:
			if (psx.noButtonPressed ()) {
				*state = ST_WAIT_COMBO_PRESS;
			}
			break;
		case ST_WAIT_COMBO_PRESS:
			buttons = debounceButtons (DEBOUNCE_TIME_COMBO);
			if (buttons != PSB_NONE && psxButton2Amiga (buttons, j)) {
				debug (F("Programmed to "));
				dumpJoy (j);

				// First look up the config the mapping shall be saved to
				byte configIdx = psxButtonToIndex (selectComboButton);
				if (configIdx < PSX_BUTTONS_NO) {
					debug (F("Storing to controllerConfig "));
					debugln (configIdx);
					
					ControllerConfiguration *config = &controllerConfigs[configIdx];

					// Then look up the mapping according to the programmed button
					byte buttonIdx = psxButtonToIndex (programmedButton);
					config -> buttonMappings[buttonIdx] = j;
				}
				
				programmedButton = PSB_NONE;
				flashLed (5);
				*state = ST_WAIT_COMBO_RELEASE;
			}
			break;
		case ST_WAIT_COMBO_RELEASE:
			if (psx.noButtonPressed ()) {
				*state = ST_WAIT_BUTTON_PRESS;
			}
			break;
		case ST_WAIT_SELECT_RELEASE_FOR_EXIT:
			if (!psx.buttonPressed (PSB_SELECT)) {
				*state = ST_JOYSTICK;
			}
			break;
			
		/**********************************************************************
		 * FACTORY_RESET
		 **********************************************************************/
#ifndef DISABLE_FACTORY_RESET
		case ST_FACTORY_RESET_WAIT_1:
			if (stateEnteredTime == 0) {
				stateEnteredTime = millis ();
			} else if (millis () - stateEnteredTime > 2500UL) {
				stateEnteredTime = 0;
				*state = ST_FACTORY_RESET_WAIT_2;
			} else if (!psx.buttonPressed (PSB_SELECT)) {
				stateEnteredTime = 0;
				*state = ST_JOYSTICK;
			}
			break;
		case ST_FACTORY_RESET_WAIT_2:
			if (stateEnteredTime == 0) {
				stateEnteredTime = millis ();
			} else if (millis () - stateEnteredTime > 2500UL) {
				stateEnteredTime = 0;
				*state = ST_FACTORY_RESET_PERFORM;
			} else if (!psx.buttonPressed (PSB_SELECT)) {
				stateEnteredTime = 0;
				*state = ST_JOYSTICK;
			}
			break;
		case ST_FACTORY_RESET_PERFORM:
			// OK, user has convinced us to actually perform the reset
			for (byte i = 0; i < 2; ++i) {
				fastDigitalWrite (PIN_LED_MODE, LOW);
				delay (500);
				fastDigitalWrite (PIN_LED_MODE, HIGH);
				delay (500);
			}
			delay (500);
			clearConfigurations ();
			saveConfigurations ();
			*state = ST_JOYSTICK;
			break;
#endif
	}
}

/** \brief Update leds
 *
 * We have a separate function for this as several machine states share the same
 * led state.
 */
void updateLeds () {
	// Pad OK led
	if (*state == ST_NO_CONTROLLER) {
		// Blink
		fastDigitalWrite (PIN_LED_PAD_OK, (millis () / 500) % 2 == 0);
	} else {
		// Steadily lit
		fastDigitalWrite (PIN_LED_PAD_OK, HIGH);
	}

	// Mode led
	switch (*state) {
		case ST_NO_CONTROLLER:
		case ST_FIRST_READ:
		case ST_WAIT_SELECT_RELEASE_FOR_EXIT:
		case ST_JOYSTICK:
		case ST_SELECT_HELD:
		case ST_SELECT_AND_BTN_HELD:
		case ST_ENABLE_MAPPING:
			// Led off
			fastDigitalWrite (PIN_LED_MODE, LOW);
			break;
		case ST_MOUSE:
			// Blink slowly
			fastDigitalWrite (PIN_LED_MODE, (millis () / 500) % 2 == 0);
			break;
		case ST_CD32:
		case ST_JOYSTICK_TEMP:
			// Led lit up steadily
			fastDigitalWrite (PIN_LED_MODE, HIGH);
			break;
		case ST_WAIT_SELECT_RELEASE:
		case ST_WAIT_BUTTON_PRESS:
		case ST_WAIT_BUTTON_RELEASE:
		case ST_WAIT_COMBO_PRESS:
		case ST_WAIT_COMBO_RELEASE:
			// Programming mode, blink fast
			fastDigitalWrite (PIN_LED_MODE, (millis () / 250) % 2 == 0);
			break;
#ifndef DISABLE_FACTORY_RESET
		case ST_FACTORY_RESET_WAIT_1:
			fastDigitalWrite (PIN_LED_MODE, (millis () / 333) % 2 == 0);
			break;
		case ST_FACTORY_RESET_WAIT_2:
			fastDigitalWrite (PIN_LED_MODE, (millis () / 80) % 2 == 0);
			break;
#endif
#ifndef DISABLE_TEST_MODE
		case ST_TEST_MODE:
#endif
#ifndef DISABLE_FACTORY_RESET
		case ST_FACTORY_RESET_PERFORM:
#endif		
			// These states handle leds in SM, don't touch
			break;
		default:
			// WTF?! Blink fast... er!
			fastDigitalWrite (PIN_LED_MODE, (millis () / 100) % 2 == 0);
			break;
	}
}

void loop () {
	stateMachine ();
	updateLeds ();

#ifdef ENABLE_DEBUG_LOOP_DURATION
	static unsigned long lastMillis = 0;
	
	unsigned long elapsed = millis () - lastMillis;
	debug (F("Elapsed ms = "));
	debugln (elapsed);
	lastMillis = millis ();
#endif
}
