godzivan/OpenPSX2AmigaPadAdapter/(commit log)

2020-04-23 Update schematics for analog output support. PCB TBD.
    [OpenPSX2AmigaPadAdapter.kicad_pcb, OpenPSX2AmigaPadAdapter.sch]
2020-04-23 Swap Ax/Wx It probably doesn't matter, but I feel better knowing that potx/y are "isolated" when AD5242 is in shutdown
    [OpenPSX2AmigaPadAdapter.sch]
2020-04-23 Add docs
    [AnalogRVals.ods]
2020-04-23 PCB modifications for analog support are complete
    [OpenPSX2AmigaPadAdapter.kicad_pcb, OpenPSX2AmigaPadAdapter.sch]
2020-04-23 Fix component naming
    [OpenPSX2AmigaPadAdapter.kicad_pcb, OpenPSX2AmigaPadAdapter.sch]
2020-04-23 Ready for V4
    [OpenPSX2AmigaPadAdapter.kicad_pcb, OpenPSX2AmigaPadAdapter.sch]
2020-04-23 Add note about R12
    [OpenPSX2AmigaPadAdapter.sch]
2020-04-23 Update analog value table
    [AnalogRVals.ods]
2020-04-24 Make schematics clearer
    [OpenPSX2AmigaPadAdapter.kicad_pcb, OpenPSX2AmigaPadAdapter.sch]
2020-04-24 Fix analog mode button 3
    [OpenPSX2AmigaPadAdapter.ino]
2020-05-08 Fix factory reset for slow-startup controllers and add Test Mode
    [OpenPSX2AmigaPadAdapter.ino]
2020-05-08 Avoid triggering axes inversion more than once per press
    [OpenPSX2AmigaPadAdapter.ino]
2020-05-08 Fully isolate ANALOG_SUPPORT stuff so that we can build for older boards
2020-05-25 Avoid spurious 0V state when entering CD32 mode
    [OpenPSX2AmigaPadAdapter.ino]
2020-05-25 Do not disable output on clock pin twice
2020-05-25 Enable INT1 ASAP when switching to CD32 mode, to avoid missing the first clock edge
    [OpenPSX2AmigaPadAdapter.ino]
2020-07-22 Only switch PIN_BTNREGOUT to OUTPUT in ISR once
