godzivan/OpenPSX2AmigaPadAdapter/(notices)

Notices in the files:
OpenPSX2AmigaPadAdapter.sch:
Licensed under CERN OHL v.1.2
